devilreraser/hw_crypto_miner_rockerbox/RockerBox_1_SiC780A_Rev02/DOC/Squid Design Specifications2.docx

# Squid Design Specifications

Revision 1.1

Assaf Gilboa and Yisrael Shulman

# 1. Glossary

Serial Loop – The serial loop that connects 8 Hammers in serial protocol and the Squid. The serial loop has serial_in, serial_out, serial_rstn, serial_clk_0 and serial_clk_1

Serial Chain – The serial chain is the serial structure which is built by concatenation of all active serial loop and at its maximum is 24 Serial Loop. The serial chain starts at dispatch point for serial packet and end at Squid as final stop

SPI – Serial Peripheral Interface standard the-facto by Motorola for synchronous serial data link

# 2. Abstract

The Squid is bridging FPGA designed to connect a single CPU with multiple ASICs.

The Squid target FPGA is Altera Cyclone 4: 15K logic elements, 343 user-IOs part# EP4CE15F23C8N package F484 (next pin compatible Altera is 30K).

Utilization target: release with less than 70%

Figure 1 - Squid system view

# 3. Feature list

- SW interface
  - SPI Slave IF - CPOL = 0 CPHA = 0
  - “Squid” serial protocol
    - Squid header
      - Read/ write
      - Squid address
      - Length in 32b
    - Payload
      - Squid register value 32bit
      - Serial transaction packet/s per length
  - Squid register set access
  - Interrupt mechanism
  - 4 GPIO In/Out – Default as Input
  - Serial SW Queue
    - TX Queue for serial packet send
    - RX Queue for serial packet returning to SW (ex. ASIC reads)
    - Can support conditional queuing
- Service routines to reduce SW polling overhead
  - HW periodic polling on 16 preconfigured serial packets
  - Each service routine can generate Interrupt/ status according to response pre
  - Configurable period between HW polling according to desired time (HW timer)
- Chain management – 24 serial loops
  - ASIC serial protocol compliancy
  - Single chain ( 24 serial loops of 8 ASICs -> 192 ASICs)
  - Active loop configuration
    - Any serial chain can be bypassed to handle faulty chain or for address allocation purposes
    - Chain can be reset independently
  - 10K Job per second maximal rate
  - Timeout to detect failing transactions
- Debug
  - HW debug I/F 10 bit bus
  - I2C Slave IF – TBD where to hook it to?

# 4. IO's and PIN assignment

Pin Name | Direction | Description | FPGA PIN | Standart | Notes
GPIO[0] | Inout | | PIN_J1 | 3.3-V LVCMOS
GPIO[1] | Inout | | PIN_H6 | 3.3-V LVCMOS
GPIO[3] | Inout | | PIN_H2 | 3.3-V LVCMOS
GPIO[2] | Inout | | PIN_H5 | 3.3-V LVCMOS
dbg_bus[0] | Out | | PIN_M1 | 3.3-V LVCMOS
dbg_bus[9] | Out | | PIN_R1 | 3.3-V LVCMOS
dbg_bus[1] | Out | | PIN_V1 | 3.3-V LVCMOS
dbg_bus[2] | Out | | PIN_N2 | 3.3-V LVCMOS
dbg_bus[3] | Out | | PIN_V2 | 3.3-V LVCMOS
dbg_bus[4] | Out | | PIN_P2 | 3.3-V LVCMOS
dbg_bus[5] | Out | | PIN_U1 | 3.3-V LVCMOS
dbg_bus[6] | Out | | PIN_P1 | 3.3-V LVCMOS
dbg_bus[7] | Out | | PIN_U2 | 3.3-V LVCMOS
dbg_bus[8] | Out | | PIN_R2 | 3.3-V LVCMOS
i2c_scl | Inout | | PIN_G5 | 3.3-V LVCMOS
i2c_sda | Inout | | PIN_G4 | 3.3-V LVCMOS
int_squid | Out | | PIN_B1 | 3.3-V LVCMOS
IN_REFCLK | In | | PIN_G1 | 3.3-V LVCMOS
ser_clk0[0] | Out | | PIN_AA21 | 1.8 V
ser_clk0[9] | Out | | PIN_AA7 | 1.8 V
ser_clk0[10] | Out | | PIN_AB5 | 1.8 V
ser_clk0[11] | Out | | PIN_V11 | 1.8 V
ser_clk0[12] | Out | | PIN_W10 | 1.8 V
ser_clk0[13] | Out | | PIN_Y3 | 1.8 V
ser_clk0[14] | Out | | PIN_AB19 | 1.8 V
ser_clk0[15] | Out | | PIN_V12 | 1.8 V
ser_clk0[16] | Out | | PIN_AA16 | 1.8 V
ser_clk0[17] | Out | | PIN_V14 | 1.8 V
ser_clk0[18] | Out | | PIN_W17 | 1.8 V
ser_clk0[1] | Out | | PIN_N19 | 1.8 V
ser_clk0[19] | Out | | PIN_B19 | 1.8 V
ser_clk0[20] | Out | | PIN_B16 | 1.8 V
ser_clk0[21] | Out | | PIN_D19 | 1.8 V
ser_clk0[22] | Out | | PIN_F12 | 1.8 V
ser_clk0[23] | Out | | PIN_A4 | 1.8 V
ser_clk0[2] | Out | | PIN_R20 | 1.8 V
ser_clk0[3] | Out | | PIN_U21 | 1.8 V
ser_clk0[4] | Out | | PIN_W20 | 1.8 V
ser_clk0[5] | Out | | PIN_C22 | 1.8 V
ser_clk0[6] | Out | | PIN_F19 | 1.8 V
ser_clk0[7] | Out | | PIN_H21 | 1.8 V
ser_clk0[8] | Out | | PIN_AA3 | 1.8 V
ser_clk1[0] | Out | | PIN_M19 | 1.8 V
ser_clk1[9] | Out | | PIN_AA8 | 1.8 V
ser_clk1[10] | Out | | PIN_AB7 | 1.8 V
ser_clk1[11] | Out | | PIN_V5 | 1.8 V
ser_clk1[12] | Out | | PIN_W6 | 1.8 V
ser_clk1[13] | Out | | PIN_Y6 | 1.8 V
ser_clk1[14] | Out | | PIN_AA13 | 1.8 V
ser_clk1[15] | Out | | PIN_W13 | 1.8 V
ser_clk1[16] | Out | | PIN_AB16 | 1.8 V
ser_clk1[17] | Out | | PIN_V15 | 1.8 V
ser_clk1[18] | Out | | PIN_Y17 | 1.8 V
ser_clk1[1] | Out | | PIN_N20 | 1.8 V
ser_clk1[19] | Out | | PIN_A19 | 1.8 V
ser_clk1[20] | Out | | PIN_B20 | 1.8 V
ser_clk1[21] | Out | | PIN_E12 | 1.8 V
ser_clk1[22] | Out | | PIN_F14 | 1.8 V
ser_clk1[23] | Out | | PIN_B5 | 1.8 V
ser_clk1[2] | Out | | PIN_R21 | 1.8 V
ser_clk1[3] | Out | | PIN_U22 | 1.8 V
ser_clk1[4] | Out | | PIN_W21 | 1.8 V
ser_clk1[5] | Out | | PIN_D20 | 1.8 V
ser_clk1[6] | Out | | PIN_F21 | 1.8 V
ser_clk1[7] | Out | | PIN_H22 | 1.8 V
ser_clk1[8] | Out | | PIN_AB3 | 1.8 V
ser_out[0] | In | | PIN_M21 | 1.8 V
ser_out[9] | In | | PIN_AB10 | 1.8 V
ser_out[10] | In | | PIN_AB9 | 1.8 V
ser_out[11] | In | | PIN_V7 | 1.8 V
ser_out[12] | In | | PIN_W8 | 1.8 V
ser_out[13] | In | | PIN_Y8 | 1.8 V
ser_out[14] | In | | PIN_AA14 | 1.8 V
ser_out[15] | In | | PIN_AA15 | 1.8 V
ser_out[16] | In | | PIN_AB17 | 1.8 V
ser_out[17] | In | | PIN_AB18 | 1.8 V
ser_out[18] | In | | PIN_AB20 | 1.8 V
ser_out[1] | In | | PIN_P22 | 1.8 V
ser_out[19] | In | | PIN_A18 | 1.8 V
ser_out[20] | In | | PIN_C19 | 1.8 V
ser_out[21] | In | | PIN_E15 | 1.8 V
ser_out[22] | In | | PIN_F16 | 1.8 V
ser_out[23] | In | | PIN_C3 | 1.8 V
ser_out[2] | In | | PIN_U19 | 1.8 V
ser_out[3] | In | | PIN_V22 | 1.8 V
ser_out[4] | In | | PIN_Y21 | 1.8 V
ser_out[5] | In | | PIN_D22 | 1.8 V
ser_out[6] | In | | PIN_H19 | 1.8 V
ser_out[7] | In | | PIN_J22 | 1.8 V
ser_out[8] | In | | PIN_AA4 | 1.8 V
ser_in[0] | Out | | PIN_M20 | 1.8 V
ser_in[1] | Out | | PIN_P21 | 1.8 V
ser_in[9] | Out | | PIN_AA9 | 1.8 V
ser_in[10] | Out | | PIN_AB8 | 1.8 V
ser_in[11] | Out | | PIN_V6 | 1.8 V
ser_in[12] | Out | | PIN_W7 | 1.8 V
ser_in[13] | Out | | PIN_Y7 | 1.8 V
ser_in[14] | Out | | PIN_AB13 | 1.8 V
ser_in[15] | Out | | PIN_Y13 | 1.8 V
ser_in[16] | Out | | PIN_AA17 | 1.8 V
ser_in[17] | Out | | PIN_W15 | 1.8 V
ser_in[18] | Out | | PIN_AA20 | 1.8 V
ser_in[19] | Out | | PIN_A16 | 1.8 V
ser_in[20] | Out | | PIN_C17 | 1.8 V
ser_in[21] | Out | | PIN_E13 | 1.8 V
ser_in[22] | Out | | PIN_F15 | 1.8 V
ser_in[23] | Out | | PIN_C10 | 1.8 V
ser_in[2] | Out | | PIN_R22 | 1.8 V
ser_in[3] | Out | | PIN_V21 | 1.8 V
ser_in[4] | Out | | PIN_W22 | 1.8 V
ser_in[5] | Out | | PIN_D21 | 1.8 V
ser_in[6] | Out | | PIN_F22 | 1.8 V
ser_in[7] | Out | | PIN_J21 | 1.8 V
ser_in[8] | Out | | PIN_AA10 | 1.8 V
ser_rstn[0] | Out | | PIN_M22 | 1.8 V
ser_rstn[9] | Out | | PIN_AB4 | 1.8 V
ser_rstn[10] | Out | | PIN_V10 | 1.8 V
ser_rstn[11] | Out | | PIN_V8 | 1.8 V
ser_rstn[12] | Out | | PIN_Y10 | 1.8 V
ser_rstn[13] | Out | | PIN_AA19 | 1.8 V
ser_rstn[14] | Out | | PIN_AB14 | 1.8 V
ser_rstn[15] | Out | | PIN_AB15 | 1.8 V
ser_rstn[16] | Out | | PIN_V13 | 1.8 V
ser_rstn[17] | Out | | PIN_AA18 | 1.8 V
ser_rstn[18] | Out | | PIN_U15 | 1.8 V
ser_rstn[1] | Out | | PIN_R19 | 1.8 V
ser_rstn[19] | Out | | PIN_A20 | 1.8 V
ser_rstn[20] | Out | | PIN_D15 | 1.8 V
ser_rstn[21] | Out | | PIN_E16 | 1.8 V
ser_rstn[22] | Out | | PIN_A10 | 1.8 V
ser_rstn[23] | Out | | PIN_D10 | 1.8 V
ser_rstn[2] | Out | | PIN_U20 | 1.8 V
ser_rstn[3] | Out | | PIN_W19 | 1.8 V
ser_rstn[4] | Out | | PIN_Y22 | 1.8 V
ser_rstn[5] | Out | | PIN_F17 | 1.8 V
ser_rstn[6] | Out | | PIN_H20 | 1.8 V
ser_rstn[7] | Out | | PIN_K15 | 1.8 V
ser_rstn[8] | Out | | PIN_AA5 | 1.8 V
spi_clk | In | | PIN_E1 | 3.3-V LVCMOS
spi_cs | In | | PIN_F2 | 3.3-V LVCMOS
spi_mosi | In | | PIN_E3 | 3.3-V LVCMOS
spi_miso | Out | | PIN_F1 | 3.3-V LVCMOS
uart_rxd | In | | PIN_C2 | 3.3-V LVCMOS | Removed
uart_txd | Out | | PIN_C1 | 3.3-V LVCMOS | Removed

# 5. Squid blocks

Figure 2 - Squid block diagram

## a. SPI Slave Specification

### I. SPI protocol

The SPI mode that in use in the Squid is CPOL = 0 CPHA = 0

The SPI works is also supporting continuous mode of operation where the transaction is longer than a single byte.

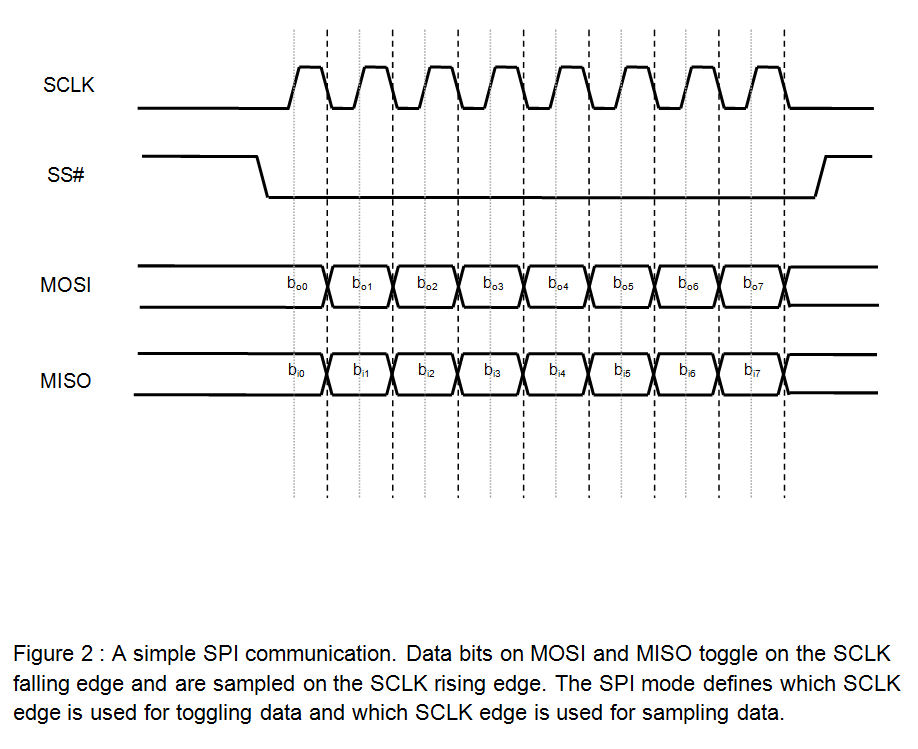
[picture p1: figure]

Figure 3 - SPI protocol

### II. SPI Low level Operation

The SPI I/F is implementing the SPI shift registers. Each sample bit is shifted till 8 shifts are done and entire byte is latched into the next block. Each 8 bits the SPI I/F is latching a ready byte into transmission.

The SPI signals are synchronized and sampled in rate which is 8x the SPI data rate

### III. SPI High level protocol

Squid incoming transaction structure (multiple SPI byte transactions)

Address[7:0] | CMD[1:0] | Length[5:0] | Data [length*32-1:0]
Squid address | 1 – Write 0 – Read | Payload Length in Words (32b) | Payload

Squid outgoing transaction structure (multiple SPI byte transactions)

Garbage[7:0] | Address[7:0] | Data [length*32-1:0]
Don’t care | Incoming Squid address field | Payload: Read – read register’s value Write – incoming reflected write payload

Figure 4 - Squid transaction

The Squid supports read and write transactions. The CPU is issuing a master “incoming Squid transaction” and in parallel the Squid is responding with outgoing transaction (see Figure #4).

When master is issuing WRITE, the Squid is reflecting at the response the written payload.

When master is issuing READ, the Squid is asserting the desired value in the “Payload” field while master “Payload” field is ignored (serves only as place holder)

The first outgoing byte is “Don’t care” since the Squid is decoding the Address at this stage.

## b. Address decoder

The Squid distinguish several types of addresses.

1) Register file - “Simple” configuration 32 bit wide registers
2) Service routine Memory which contains “Hammer Serial” service routine written by SW by address
3) Serial TX FIFO address which serves to store “Hammer’s serial” packets which destined to the Hammer chain. Each write is pushing the 32bit word into the Serial FIFO of transmit (no read access).
4) Serial RX FIFO address which serves to store “Hammer’s serial” packets which returned from the Hammer chain and are marked to be read by SW. Each SW read will pop a 32bit word from the FIFO to the SPI (no write access).
5) Service RX FIFO address which serves to store “Hammer’s serial” packets which returned from the Hammer chain, are marked to be read by SW and originated from the service routine. Each SW read will pop a 32bit word from the FIFO to the SPI (no write access).

Address range | Destination
0x00 – 0x3F | Register file
0x40 – 0x7F | Service routine Memory
0x80 | Serial TX FIFO
0x81 | Serial RX FIFO
0x82 | Service RX FIFO

Table 1 - Address decoding

## c. Serial Queue

The serial Queue is allowing the SW to write continuously into the “Hammer serial” as long as there is an available space in the FIFO.

The TX and RX FIFOs will hold enough space to contain at least 2 full Jobs – 64x32bits words.

The Serial Queue will hold a SW readable status of the both TX Queue and RX Queue and will allow interrupts over full/empty state of the FIFO.

While the TX queue is filled by the SW, the returning RX Queue is filled by the HW. Each “Hammer Serial” transaction sent is returning to the Squid and the Squid parse the “Hammer serial” packet and acts according to the “general” bits at the tail of the packet.

The general bits provide the additional info from which the Squid is routing the “Hammer serial” returning packet to the right Queue or discard it all together

### I. Serial packet general bits usage

- Completion bit by SW (C) – 1 - Store the response if asserted (according to Condition if set). 0 – Discard the returning packet
- Conditional bit by SW (CC) – 1 - Test the “Hammer serial” value to be non-zero. If the value field 16lsb is non-zero and Completion bit asserted – store the packet. 0 – Don’t test the value, act by Completion bit only.
- RX Q destination (Q) – Set by HW (SW shouldn’t use this bit) to designate whether the packet arrived from service or serial Q and to store it at the right RX Q
- HW test (CNT) – bits set by HW to detect “Hammer serial” failures

C bit | CC bit | Action
0 | 0 | No response for the serial packet
0 | 1 | No response for the serial packet
1 | 0 | Store serial packet in Q
1 | 1 | Store serial packet in Q if “Value[15:0]” field is non-zero

Table 2 – General bit Completion and Conditional Completion Action

Figure 5 - Serial Packet general bit

## d. Packet Formatter

Packet Formatter will receive SPI bytes and format these bytes to 32bits transactions according to header. The packet formatter also toggle the bytes of the response to the direction of the SPI.

## e. Loop Management

Each Serial loop can route Serial_in through the Hammer loop or simply short the loop and send Serial_in to serial_out directly. The loop manager is running 10MHz like the Hammer serial. The manager also provide serial clock to the Hammer serial

### I. Bypass

The Squid is enabling bypass per serial loop.

In order to bypass a loop:

1) Verify there is no serial packet in the chain:
  a. Stop the service routine from injecting packets
  b. Serial Q status should be empty
  c. Packets in the chain indication is zero
  d. Write the bypass register with the desired value
2) The loop which bypass is set will pass the serial packet and maintain the loop’s serial_out in zero

### II. Error Detection

The serial chain logic is responsible to detect and report serial errors.

Since a packet is traversing a board and ~200 Hammer chips, there are a lot of failure points along the chain.

Types of errors:

1. Packet corruption – the packet is damaged by mal-operating component
2. Packet is lost – disconnect of serial somewhere

Detection:

1. Packet corruption
  a. Need to be end-to-end since Hammers can change data (parity, CRC will not work properly). The protection is per Chain
  b. Packet based since the packets are cut-thru
  c. Each serial packet entering will be marked with up-counting counter at its CNT general bits (see figure - Serial Packet general bit)
  d. Each serial packet exiting is expecting the “right” marking on the CNT bits
  e. Corrupted packets will have the marking wrong
  f. This marking will protect from serial packet shifts and systematic corruption.
  g. It will not protect from well-formed packets which interior data is bad
2. Packet Loss
  a. Packets which doesn’t return will not be detected by corruption since disappeared
  b. Every packet that goes into a loop MUST come out at the end of loop
  c. A loop is 8 Hammers long and a packet head is exiting a loop before tail has entered
  d. For each “start bit” on serial out trigger a timer, if start bit is not arriving on serial in after TBD configured cycles -> Error
  e. If arrived, reset trigger and wait for next “start bit”

Figure 6 - Loop logic

## f. Service routine - TBD

The Service routine is composed of 16 routines with 64 Words memory which hold Raw SPI protocol data with CMD, Address Etc. The service routine block will pump the data stored in his memory in predefined intervals. The certain service routine is enabled when the service routine are globally enabled as well as per routine enabled. The service routine are taking lower priority than the Serial Queue, and will be entering the serial only if the Serial Queue is idle. The service routine can be globally stopped to allow the SW to “drain” the Hammer serial in cases that reset or bypass are required.

## g. Interrupt service

The Squid has a dedicated line of interrupt towards the ARM. The Interrupt will be asserted when ISR register will hold a non-zero value.

The ISR is a register that holds vector of interrupts bitwise corresponding the STATUS register i.e. STATUS[0] will set ISR[0] if conditions are met.

ISR[i] asserted when:

STATUS[i] & IMR[i] asserted or ISR[i] & ITR[i] & ~ICR[i] & IMR[i]

The first (red) condition is referring to unmasked level events happening

The second (blue) condition is for temporary events that need capture, these events once captured are asserted till cleared.

Please refer to ITR register for sticky/ non-sticky type and ICR register for clear operation.

## h. Register set

Register name | Address | Description
REVISION | 0x0 | Squid RTL revision
STATUS | 0x1 | Squid status and error indications
ISR | 0x2 | Squid interrupt status register
IMR | 0x3 | Squid interrupt mask register
ICR | 0x4 | Squid interrupt clear register
ITR | 0x5 | Squid interrupt type register
PONG | 0xF | Squid fixed value register for “SPI health” read
LOOP_RESET | 0x10 | Squid loop reset vector
LOOP_BYPASS | 0x11 | Squid loop bypass vector
LOOP_TIMEOUT | 0x12 | Squid loop error of disconnection
SCRATCHPAD | 0x1F | Squid scratchpad register for write/read
COMMAND | 0x20 | Squid pulse command
QUEUE_STATUS | 0x21 | Squid Queue status
SERVICE_STATUS | 0x22 | Squid Service Routine status
SR_CONTROL | 0x30-0x3F | Squid Service routines control – 16 routines
SR_MEMORY | 0x40–0x5F | Squid “Serial packets” for service routine 2 per routine
SERIAL_WRITE | 0x80 | Squid serial queue FIFO write address
SERIAL_READ | 0x81 | Squid serial queue FIFO read address
SERVICE_READ | 0x82 | Squid service routine FIFO read address

Table 3 – Squid Register Set

### I. REVISION

The register holds read only

Field | Type | Default | Range | Description
REVISION | RO | | 15:0 | holds the RTL revision of the Squid

### IV. STATUS

Field | Type | Default | Range | Description
// Serial Queue indications
Serial Q TX full | RO | | 0 | The Serial TX FIFO is full
Serial Q TX not empty | RO | | 1 | The Serial TX FIFO is not empty
Serial Q TX empty | RO | | 2 | The Serial TX FIFO is empty
Serial Q RX full | RO | | 3 | The Serial RX FIFO is full
Serial Q RX not empty | RO | | 4 | The Serial RX FIFO is not empty
Serial Q RX empty | RO | | 5 | The Serial RX FIFO is empty
// Service Queue indications
Service Q RX full | RO | | 6 | The Service RX FIFO is full
Service Q RX not empty | RO | | 7 | The Service RX FIFO is not empty
Service Q RX empty | RO | | 8 | The Service RX FIFO is empty
// Queue Errors
FIFO Serial TX Error | RO | | 9 | Serial TX FIFO underrun or overrun
FIFO Serial RX Error | RO | | 10 | Serial RX FIFO underrun or overrun
FIFO Service RX Error | RO | | 11 | Service RX FIFO underrun or overrun
// Loop Indication
Chain Empty | RO | | 12 | The serial loops are empty – no packet is traversing the serial chain
Loop Timeout Error | RO | | 13 | The loop has detected timeout on packet return see LOOP_TIMEOUT
Loop corruption Error | RO | | 14 | The serial loop has returned a malformed serial packet
Illegal access | RO | | 15 | The SW has accessed a non-existing address

### V. ISR

Interrupt Status Register holds the active interrupts of the Squid.

The register is Read Only, Width as STATUS reg.

The register when not zeroed is asserting the interrupt to CPU

Upon Interrupt the SW needs to read and this register.

The ISR bits’ offset is corresponding to the STATUS bit offset (interrupt is available per STATUS bit).

### VI. IMR

Interrupt mask register. Each bit affects the bit order corresponding ISR bit.

The register is of Read-Write type , Width as STATUS reg.

1 - The interrupt will be mask

0 – The interrupt is enabled

Default value is 1 – No interrupts are enabled after reset

### VII. ICR

Interrupt clear register. Each bit affects the bit order corresponding ISR bit.

The register is of Write-Only type (Read will return illegal value), Width as STATUS reg

The Clear act as a clearing pulse to sticky interrupts.

1 – Clear interrupt

0 – Don’t clear

Using the Clear on non-sticky interrupts will have no effect on interrupt

### VIII. ITR

Interrupt type register. Each bit affects the bit order corresponding ISR bit.

The register is of Write-Read, Width as STATUS reg.

The type can be Sticky or non-sticky.

Sticky interrupt is keeping interrupt asserted even if the event has passed ex. Pulse.

The ITR register will be set to the right default value and need not be set by SW (debug only).

By default:

Levels of FIFO (full/empty/non-empty) are non-sticky and shows current state.

Errors are sticky still collected by error pulses and are kept (if not masked) till cleared

### IX. PONG

The register holds read only value.

Field | Type | Default | Range | Description
PONG | RO | 0xDEADBEEF | 31:0 | holds the PONG value for SW polling

The register is for SPI keep alive purposes.

Since the SPI is vital communication channel the SW polls periodically for “health check” of the SPI. The register serves as a fixed SW agreed value that once SW read is mismatched detect SPI hang/ bug.

SPI hang is fatal bug and require Squid reset

### X. LOOP RESET

The loop reset is a vector of reset to the Serial Loop. The reset is directly connected to the Squid SERIAL_RSTN.

Field | Type | Default | Range | Description
SERIAL_RSTN | WR | 0x0 | 23:0 | Each bit is resetting a loop, 0 – reset is active; 1 – reset is inactive.

### XI. LOOP BYPASS

The loop bypass is a register that enable bypassing each loop (see “loop management”).

Note: changes are allowed only when no serial activity or pending packets exist

Field | Type | Default | Range | Description
LOOP BYPASS | WR | 0x0 | 23:0 | Each bit is bypassing a loop, 0 – don’t bypass; 1 – bypass loop insert zeroes to the loop.

### XII. LOOP_TIMEOUT

Field | Type | Default | Range | Description
LOOP TIMEOUT | WR | 0x0 | 23:0 | Bit per loop, 0 – no timeout occur; 1 – timeout occurred.

The LOOP_TIMEOUT holds per loop the event of packet loss in the loop. The loop is detecting “start_bit” and expects to see a “start_bit” returning. If the “start_bit” is not returning throughout the packet (64 cycles), the loop will assert a “loop timeout” which designates a disconnection in the loop.

If “LOOP_TIMEOUT” is non-zero the “STATUS. Loop Timeout Error” will be asserted.

Writing zero to this register will de-assert the “STATUS. Loop Timeout Error”. The register is written by HW when detecting a timeout and by SW clearing a timeout.

### XIII. SCRATCHPAD

A register for read write operations, has no design impact. For bring-up/ SW purposes.

Field | Type | Default | Range | Description
SCRATCHPAD | WR | 0x0 | 31:0 | Has no HW functionality

### XIV. COMMAND

The Command register holds operation modes and reset ability to the Squid

Note: changes are allowed only when no serial activity or pending packets exist

Field | Type | Default | Range | Description
Serial Q TX FIFO reset | WR | 0x0 | 0 | Reset FIFO to empty state, data stored will be lost
Serial Q RX FIFO reset | WR | 0x0 | 1 | Reset FIFO to empty state, data stored will be lost
Service Q RX FIFO reset | WR | 0x0 | 2 | Reset FIFO to empty state, data stored will be lost
Loop logic reset | WR | 0x0 | 3 | Reset serial I/F logic (see detailed)
Service routine enable | WR | 0x0 | 4 | Enable the service routine feature

Loop logic reset – the reset should be done only in extreme cases where the serial I/F is in error state (for debug purposes). The logic under this reset is the insertion of packets to the serial I/F, the bit aggregation of serial packets coming from the serial I/F and the service routine logic. Resetting the loop logic can cause Hammers to receive incomplete packets.

### XV. QUEUE STATUS

Field | Type | Default | Range | Description
Serial TX FIFO Used | RO | | 7:0 | The number of occupied 32bits lines
Serial RX FIFO Used | RO | | 15:8 | The number of occupied 32bits lines
Service RX FIFO Used | RO | | 23:16 | The number of occupied 32bits lines

### XVI. SERVICE_STATUS

Field | Type | Default | Range | Description
SERVICE_STATUS | RO | | 15:0 | Pending Service Routine

The register states whether service routine is pending handling or not. The trivial case is that the SERVICE_STATUS will be zeroes. The register is required to assure when “loop actions” such as bypass and reset are needed, the service routine is not pending completion. When a service routine is pending, need to wait to its completion.

1- Pending Request
2- No Pending request

### XVII. SR_CONTROL

The register is containing the required timer that is used to create the period of the routine and enablement of the routine.

Field | Type | Default | Range | Description
Service Routine Counter | WR | 0x7FFFFFFF | 30:0 | The timer of service routine
Service routine enable | WR | 0x0 | 31 | Enable bit of service routine

The SR_CONTROL registers are 16 registers for service routine 0 to 16.

Each SR_CONTROL and service routine can be set and work independently.

The Service Routine Counter holds the service routine period:

Service Routine Period = Service Routine Counter holds x 100 nS;

Note: Changing timer should be done via enable = 0 only it is no allowed to change timer to a running routine.

The minimal value expected is 500 (50uS).

### XVIII. SR_MEMORY

The SR_MEMORY is the service routine memory space. The Memory is can be read and written in random. No default value exists.

Each service routine takes up 2 consecutive 32bit address ex. Service routine #5 takes addresses (SR_MEMORY_BASE + 0xA) and (SR_MEMORY_BASE + 0xB).

The Service Routine Memory needs to written prior to the SR_CONTROL which enables it.

### XIX. SERIAL_WRITE

Field | Type | Default | Range | Description
SERIAL_WRITE | WO | | 31:0 | Serial Q TX FIFO write address

The register is access to the Serial TX Q FIFO. The write strobe is making a “push” to the FIFO. The register cannot be read. No reset value is relevant.

All accesses to serial I/F are done by writing this address.

Note: Prior to writing the address SW needs to assure the FIFO has sufficient place. Writing a full FIFO will be discarding the overflowing access and potentially make the Squid out of sync.

### XX. SERIAL_READ

Field | Type | Default | Range | Description
SERIAL_READ | RO | | 31:0 | Serial Q RX FIFO read address

The register is access to the Serial RX Q FIFO. The read strobe is making a “pop” to the FIFO. The register cannot be written. No reset value is relevant.

All accesses to returning serial packets are done by reading this address.

Note: Prior to reading the address SW needs to assure the FIFO is not empty. Reading an empty FIFO will be retrieving a non-relevant data and potentially make the Squid out of sync.

### XXI. SERVICE_READ

Field | Type | Default | Range | Description
SERVICE_READ | RO | | 31:0 | Service Q RX FIFO read address

The register is access to the Service RX Q FIFO. The read strobe is making a “pop” to the FIFO. The register cannot be written. No reset value is relevant.

All accesses to service routine returning serial packets are done by reading this address.

Note: Prior to reading the address SW needs to assure the FIFO is not empty. Reading an empty FIFO will be retrieving a non-relevant data and potentially make the Squid out of sync.
