devilreraser/hw_crypto_miner_rockerbox/RockerBox_1_SiC780A_Rev02/DOC/ds_rockerbox_draft_v1.1.pdf

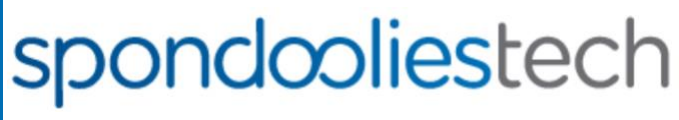
[picture p2: figure]

### www.spondoolies-tech.com

This document contains proprietary and confidential material of Spondoolies-Tech Ltd. Any unauthorized reproduction, use, or disclosure of this material, or any part thereof, is strictly prohibited. This document is solely for the use of Spondoolies-Tech employees and authorized Spondoolies-Tech customers.

The material furnished in this document is believed to be accurate and reliable. However, no responsibility is assumed by Spondoolies-Tech Ltd. for the use of this document or any material included herein.

Spondoolies-Tech Ltd. reserves the right to make changes to this document or any material included herein at any time and without notice.

Spondoolies-Tech, and Hammer are trademarks of
Spondoolies-Tech Ltd.

© Copyright Spondoolies-Tech Ltd. 2014 – Confidential

# RockerBox™ ASIC Data Sheet (Provisional)

# Version 1.1

# Jun 2

## Doc. No. ds_rockerbox_draft.doc

## Part No. Rockerbox

RockerBox™ ASIC

June 14 | i Proprietary and Confidential

This document specifies the electrical, mechanical and thermal parameters of the RockerBox™ Bitcoin mining ASIC.

It is intended for design engineers incorporating the chip into printed circuit boards.

Additionally, its initial chapter can be used as an overview of the RockerBox™ Bitcoin mining ASIC by management and non-technical staff.

RockerBox™ ASIC

June 14 | ii Proprietary and Confidential

### Table of Contents

RockerBox™ ASIC

June 14 | iii Proprietary and Confidential

### 7 About Spondoolies-Tech | 27

7.1 Contact Information | 27

### List of Figures

Figure 1-1: RockerBox™ schematic | 2
Figure 6-2: Package dimensions | 24
Figure 6-3: Recommended footprint – view from top | 25

Figure 6-4: Example of ASIC peripheral layout placement including the companion
Dc/Dc | 26

### List of Tables

Table 1-1: Key system parameters of chip operation in typical corner | 1
Table 4-1: Frequency settings | 11
Table 4-2: Packet structure | 14
Table 4-3: Register set | 15
Table 5-1: Pin assignments | 23

RockerBox™—Overview

June 14 | 1 Proprietary and Confidential

## 1 Overview

The document describes the features and operating flow of the RockerBox chip, a Bitcoin optimized multiple double SHA-256 engines ASIC.

The RockerBox contain 193 double SHA low-power, high-performance engines, which can be chained to any number of other RockerBox ASICs via a proprietary serial interface tailored for this purpose.

## 1.1 Key Features

Double SHA-256 cores

- 193 fully-unrolled engines, each performs a single hash per cycle
- Engine integrity test support—BIST
- Up to 0.2THash/s in typical process corner
- Low power consumption 0.3W/GHps

Built In Self-Test (BIST)

- Engine embedded test mechanism that asserts the integrity of the engine
- Enables validating the adequacy of Operating Condition to engine operation

Power Efficient

- The RockerBox chip can work in core voltages 550—800mV
- Each engine can be shutdown logically or physically by clock shutdown for power save purposes

Serial Interface

- Supports any number of devices on a board
- Seamlessly adding or reducing devices
- Addressing scheme to support ASIC broadcasting transactions
- Low pin count – clock, data in, data out
- Can run up to 50 MHz continuous data rate

Thermal Sensors and thermal shutdown

- Two thermal sensors configures to eight levels. Ranges 90 to 125 °C equally spaced.
- Thermal sensors can invoke engine shutdown upon over-heating, to prevent ASIC meltdown

Configurable PLL

- Supports core frequencies
from 500—1500 MHz.

Table 1-1: Key system parameters of chip operation in typical corner

units
Core voltage | 600 | 700 | mV
Frequency | 900 | 1100 | MHz
Performance | 174 | 212 | GHs
Power/performance | 0.3 | 0.4 | W/GHs
Power | 55 | 90 | W

RockerBox™—Overview

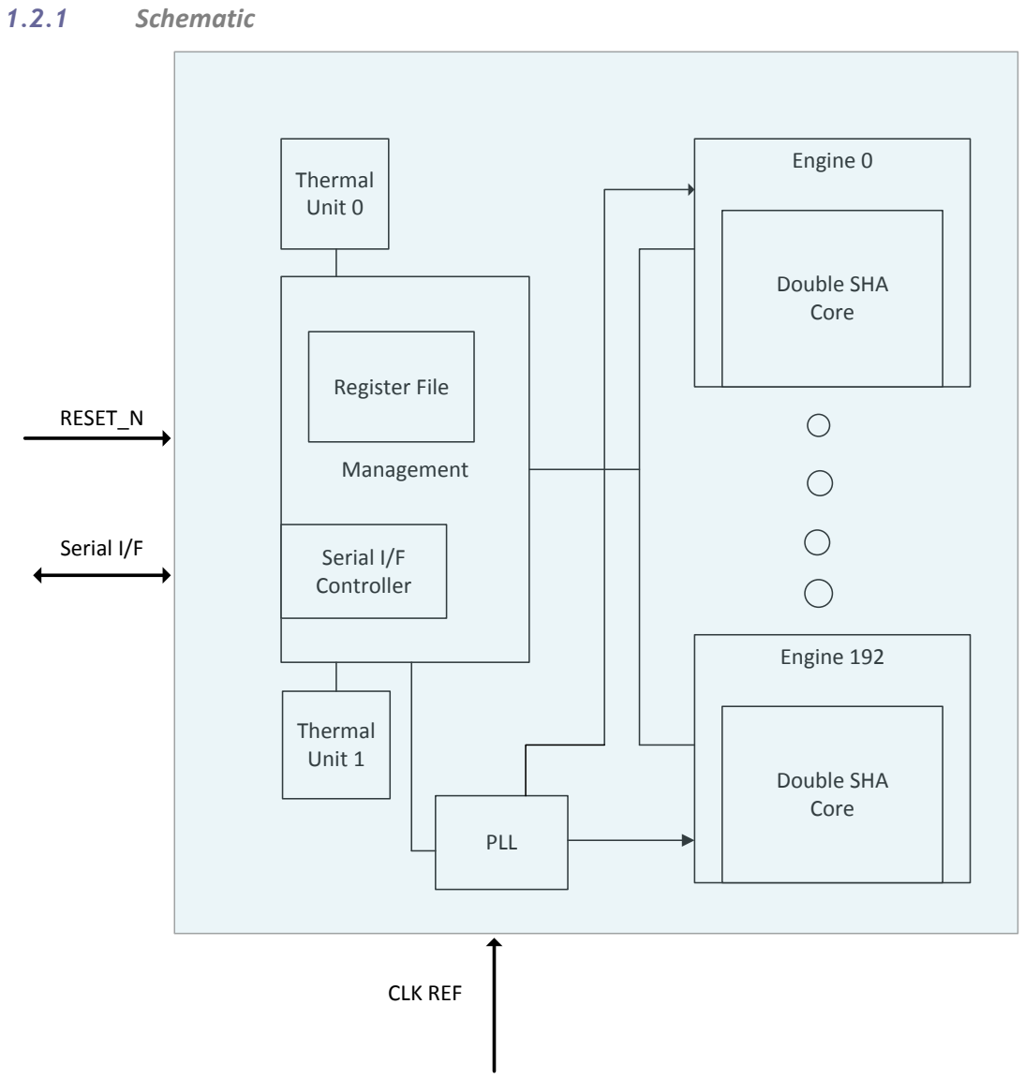
[picture p3: figure]
1.2.1 Schematic; PLL; Thermal Unit 0; Management; Engine 0; Double SHA Core; Engine 192; Thermal Unit 1; Register File; Serial I/F Controller Serial I/F; CLK REF; RESET_N

June 14 | 2 Proprietary and Confidential
1.2 | System Overview

Figure 1-1: RockerBox™ schematic

RockerBox™—Electrical Specifications

June 14 | 3 Proprietary and Confidential

## 2 Electrical Specifications

## 2.1 Normal Operating Conditions

Unless otherwise specified, all DC and AC specifications in this data sheet are valid for the following voltages and temperature ranges.

| Operating Range
Operating Temperature | TA= 0 oC to 70 oC
Parameter | Symbol | Min. | Typical | Max. | Units
Digital Power Supplies | VDDC | 0.60 | 0.70 | 0.80 | VDC
| VDDIO | 1.62 | 1.8 | 1.98 | VDC
Analog Power Supplies for Ambient Temperature | VDDPLLIO | 1.62 | 1.8 | 1.98 | VDC
| VDDPLLC | 0.81 | 0.9 | 0.99 | VDC
| TA | 0 | | 85 | °C
Junction Temperature | TJ | 0 | | 125 | °C
2.2 | Power Requirements
Condition | Parameter | Typical | Max | Units
VDD=0.7V | VDD | 130 | 160 | A
VDD=0.6V | VDD | 90 | 110 | A
VDDIO=1.98V | VDDIO | | 40 | mA
PLLAVDD=1.98 V | PLLAVDD, | | 5 | mA
TSAVDD =1.98V | TSAVDD | | 5 | mA
PLLDVDD=0.99 V | PLLDVDD | | 5 | mA

RockerBox™—Chip Operation

June 14 | 4 Proprietary and Confidential

## 3 Chip Operation

## 3.1 Chip Initialization

The RockerBox™ chip master reset is the RST_N pin. The RST_N is active low asynchronous reset.

### 3.1.1 Reset

1. Assert low the RST_N for 1uS
2. De-assert the RST_N

### 3.1.2 Serial Clock

The serial clock is the management clock of the system; it is always active during operation.

### 3.1.3 Allocating an address

See “Address Allocation” flow.

### 3.1.4 Enabling Global Clocks

The RockerBox has a global hash clock enable and global hash reset enable.

It is recommended to enable the hash clock and reset in the initialization flow.

1. Write ‘1’ to GLOBAL_HASH_RESETN register
2. Write ‘1’ to GLOBAL_CLK_EN register

### 3.1.5 Setting a Frequency

The PLL is turned off by default. You need to initialize the PLL to the desired frequency of operation. See “PLL frequency change”

## 3.2 Address Allocation

Address allocation is the process that assigns an address to the chip.

The chip address register is CHIP_ADDRESS and it holds the 16-bit unique chip address.

Note: the CHIP_ADDRESS register cannot be written when register GOT_ADDRESS is ‘1’. i.e. you cannot change an address to an allocated chip. Need to do address de-allocation first. When getting out of reset the chip is de-allocated
Single chip address allocation:
- Make a serial transaction with following fields: register address CHIP_ADDRESS, chip address 0xFFxx (broadcast), type WRITE, value desired address of 16-bit. The allowable addresses are 256 aligned (0x0, 0x100, 0x200,….,0xFC00) thus single chip chain can contain maximal number of 252 chips.
Single chip address allocation verification:
- Read address allocation status -Make a serial transaction with following fields: register address GOT_ADDRESS, chip address assigned address, type READ, value don’t care

RockerBox™—Chip Operation

June 14 | 5 Proprietary and Confidential

Multiple chips address allocation:

- When several chips are daisy chained, the allocation process is repeated to the number of address unallocated chips chained.
1) De-assert mask the corresponding masking of INTERRUPT_STATUS.GOT_ADDRESS_NOT by broadcast writing ‘0’
2) Broadcast Read “BC_GOT_ADDR_NOT”
3) If value is ‘1’, address unallocated chips exist, broadcast write CHIP_ADDRESS with new address which wasn’t allocated in this chain. Else if value is ‘0’ the process has ended

To de-allocate an address:

- In order to alter a chip’s address, write ‘0’ to the GOT_ADDRESS.
The chip allows removing address to all daisy chained chips by a broadcast write to GOT_ADDRESS

## 3.3 Engine Enable/Disable

The flow details the action to be taken when enabling or disabling engines. You can take enable and disable actions on any number of engines concurrently.

The disable flow also shuts down the engine power-wise, and the shutdown engine will consume a very small fraction of its operating power. This is caused by leakage only (clocks are off and reset is on).

All the actions below can be done to multiple engines and/or in broadcast mode
To enable engine Y:
1. Un reset the engine Y from SERIAL_RESETN_ENGINES_X register:

SERIAL_RESETN_ENGINES_X is a register containing 32 bits vector of active low reset for 32 consecutive engines

Engines 0 to 193 are mapped such that engine Y is mapped to SERIAL_RESETN_ENGINES_{floor(Y/32)}[Y%32]

Write ‘1’ to engine Y mapped bit

2. Un reset the FIFO_RESR_N of an engine by write ‘1’ to CONTROL.FIFO_RESET_N or CONTROL_SET1
3. Enable the engine digital logic by writing ‘1’ to relevant bit in ENABLE_ENGINES_X register (same Y to X bit mapping as detailed above)
To disable engine/engines:
4. Disable the engine digital logic by writing ‘0’ to relevant bit in ENABLE_ENGINES_X register (same Y to X bit mapping as detailed above)
5. Reset the engine by writing ‘0’ to the relevant bit in SERIAL_RESETN_ENGINES_X register (same Y to X bit mapping as detailed above)

RockerBox™—Chip Operation

June 14 | 6 Proprietary and Confidential
3.4 | PLL Frequency Change

To set the PLL frequency:

1. Change frequency when engines are disabled in order to avoid glitches and other undesired phenomena. See “engine enable/ disable” flow
2. Write the desired frequency (according to PLL table) :
a. PLL_CONFIG.M - holds M-1 value where M (Multiplier) is the value of multiplication from Table 4-1
b. PLL_CONFIG.N - holds N-1 value where N (Pre divisor) is the value of pre divisor from Table 4-1
c. PLL_CONFIG.P – holds P-1 value where P (Post divisor) is value of post divisor from Table 4-1
d. PLL_CONFIG.BYPASS – always `0`
e. PLL_CONFIG.FSE – always `1`
3. De-assert PLL_ENABLE by writing ‘0’
4. Assert PLL_ENABLE by writing ‘1’
5. Optionally verify the PLL is ready by reading PLL_STATUS.PLL_READY
6. Optionally verify across all chip daisy chained by broadcast read of BC_PLL_NOT_READY that returning value is zero (all chips are PLL ready)
7. Activate desired engine. See Engine Enable/Disable flow

## 3.5 Thermal Sensor Activation

To activate a thermal sensor:

Both Thermal sensors are off by default. Each can serve for thermal reading only or thermal shutdown only. This section is detailing the sensor reading.

1. Reset the THERMAL_SENSOR_RSTN_0 and/or THERMAL_SENSOR_RSTN_1 by writing ‘0’
2. Set the desired level to compare THERMAL_SENSOR_SET_0.SETTING or/and THERMAL_SENSOR_SET_1.SETTING to a value 0 to 7 correlated to 100,105,110,115,120, 125°C and set THERMAL_SENSOR_SET_0.THERMAL_SHUTDOWN_EN or/and to THERMAL_SENSOR_SET_0.THERMAL_SHUTDOWN_EN ‘0’.
3. Un-Reset the THERMAL_SENSOR_RSTN_0 and/or THERMAL_SENSOR_RSTN_1 by writing ‘1’ to allow reading
4. Reading can be done by a direct read to THERMAL_SENSOR_DATA_0 or/and THERMAL_SENSOR_DATA_1 – a ‘1’ means the temperature is higher than the level set and ‘0’ means the temperature is lower than level set. The accuracy is 5°C and some hysteresis mechanism is implemented in the thermal sensor in order to eliminate noise
5. Another read method is by using broadcast along chain of ASICs and receive the chip address of these ASICs, which are above or below. This can be done by BC_TS_* register family. Please refer to broadcast operation in the Serial Interface chapter.

RockerBox™—Chip Operation

June 14 | 7 Proprietary and Confidential
3.6 | Thermal Shutdown

To configure thermal shutdown:

The chip can protect itself from overheating. The feature is by default disabled and requires activation.

1. Set the SHUTDOWN_ACTION to 0xFFFF. This will minimize the chip power consumption by shutting all engines.
2. Reset the THERMAL_SENSOR_RSTN_0 and/or THERMAL_SENSOR_RSTN_1 by writing ‘0’
3. Set the desired level to compare THERMAL_SENSOR_SET_0.SETTING or/and THERMAL_SENSOR_SET_1.SETTING to a value 0 to 7 correlated to 100,105,110,115,120, 125°C and set THERMAL_SENSOR_SET_0.THERMAL_SHUTDOWN_EN or/and to THERMAL_SENSOR_SET_0.THERMAL_SHUTDOWN_EN ‘1’.
4. Un-Reset the THERMAL_SENSOR_RSTN_0 and/or THERMAL_SENSOR_RSTN_1 by writing ‘1’ to allow reading
5. A periodic broadcast polling on BC_THERMAL_SHUTDOWN register will return ‘1’ ( and address ) if thermal shutdown has occurred.
6. After a shutdown event occurs, the event is stored in the interrupt mechanism as a “sticky” event. We recommend initializing the chip after such event.

3.7 Job

The job flow is the collective registers and actions to have hashing running and monitoring the win. The job is run over the active engines (required at least one engine active) which are preconfigured with the following:

1. Nonce start, which is configured by user to each engine via NONCE_START register
2. The range of nonces to cover, which is configured by user to each engine via NONCE_RANGE register. It is recommended all engines share same range and run same time. This register can be written in broadcast access to all engines in parallel
3. Leading zeroes. This configuration determines the “win” indication criteria as leading zeroes from second hash. The RockerBox supports up to 64 leading zeroes WIN_LEADING_0 register holds the value in each engine.
Per Job
1. Write each relevant (active) engine MIDSTATE0-MIDSTATE7 , MARKEL, DIFFICULTY, TIMESTAMP and optionally JOBID to track the vector (can be written to all engines concurrently).
2. Write the relevant engines with COMMAND.LOAD_FIFO to load the job to FIFO (FIFO overrun is not damaging)
Win Detection
1. Either by reading BC_WIN or INTERRUPT_STATUS.WIN unicast or broadcast
2. Each engine keeps its own WIN, so when reading BC_WIN the response includes winner engine index, the index can be read separately from WINNER_ENGINE_ID
3. Read WINNER_NONCE and WINNER_JOBID for winning parameters

RockerBox™—Chip Operation

June 14 | 8 Proprietary and Confidential
4. Clear the “win” indication at the winning engine by COMMAD.WIN_CLEAR (the command should be addressed to the winner engine)

RockerBox™—Chip Operation

June 14 | 9 Proprietary and Confidential
3.8 | STATUS / INTERRUPT Mechanism

The RockerBox chip supports an interrupt-like mechanism, which is accessed by a read operation.

In order to ease the software managing of numerous devices, each of the status bit is mapped to a unique register for broadcast read.

The mechanism comprises:

1. Interrupt raw register “INTERRUPT_RAW” which holds the indications unmask status
2. Interrupt mask register “INTERUPT_MASK” which masks per bit indications when written ‘1’
3. Interrupt clear register “INTERRUPT_CLEAR” which clears sticky indications when written ‘1’
4. INTERRUPT_STATUS register “INTERRUPT_STATUS” which holds the unmasked indications INTERRUPT_STATUS = INTERRUPT_RAW & ~INTERRUPT_MASK
5. Per INTERRUPT_STATUS broadcast address which spreads each of the INTERRUPT_STATUS bits to unique address for broadcast read purposes

## 3.9 BIST

The BIST flow enables to run all engines in parallel on a well-known job. The participating engines are the enabled one (disable engines will not indicate failure). The BIST should be run as a single Job in the engine/s, i.e. need to wait till BIST ends, read results and only then return to normal operation.

The Job below is a predefined Job with a known expected result, the BIST can be done for each engine and in parallel (in parallel broadcast access can be utilize)

1) Write MID_STATE0 0xBC909A33
2) Write MID_STATE1 0x6358BFF0
3) Write MID_STATE2 0x90CCAC7D
4) Write MID_STATE3 0x1E59CAA8
5) Write MID_STATE4 0xC3C8D8E9
6) Write MID_STATE5 0x4F0103C8
7) Write MID_STATE6 0x96B18736
8) Write MID_STATE7 0x4719F91B
9) Write MERKLE_ROOT 0x4B1E5E4A
10) Write TIMESTAMP 0x29AB5F49
11) Write DIFFICULTY 0xFFFF001D
12) Write WIN_LEADING_0 0x32 (high enough to avoid win over BIST vector)
13) Write BIST_NONCE_START 0x1DAC2A7D
14) Write BIST_NONCE_RANGE 0x200
15) Write BIST_CRC_EXPECTED 0xBDE23FFF
16) Move relevant engine/s to BIST mode – Write CONTROL_SET1 0x1

RockerBox™—Chip Operation

June 14 | 10 Proprietary and Confidential
17) Write the BIST_ALLOWED_FAILURE_NUM register with the tolerance to failed engine
18) Write COMMAND.LOAD_FIFO to the relevant engine/s to commence the BIST start
19) Wait for 2uS or poll on BC_IDLE register to verify BIST is done
20) Read BC_BIST_EXP_FAIL (need to verify the INTERRUPT_MASK is enabling the) should be zero
21) Explicit BIST status per can be read directly from BIST_PASS_X register at each chip (BIST_PASS_0 holds engines 0 to 31 )
22) Clear BIST related wins by COMMAND.WIN_CLEAR to the BIST engines
23) De-assert the BIST mode by write Write CONTROL_SET0 0x1

RockerBox™—Chip Functionality

June 14 | 11 Proprietary and Confidential

## 4 Chip Functionality

## 4.1 PLL Range

The RockerBox chip contains a PLL to clock the hash. We recommend using the system validated 30MHz input reference clock.

The PLL has three parameters to create a frequency: M,N and P.

The output FOUT frequency is computed as follows:

- FVCO = M*FIN/N
- FOUT = FVCO/P

Limitations:

- 10 MHz < FIN < 187.5 MHz
- 1600 MHz < FVCO < 3000 MHz
- Desired engine frequency is FOUT/2 (averaging the engine power consumption)

Table 4-1: Frequency settings

- Recommended setting for FIN=30MHz
Input Frequency (MHz) | N Divider | M Multiplier | P Divider | Engine's Frequency
Range: 10-200 | Range: 1-32 | Range: 16-256 | Range: 1-64 | Range: 500-1000 MHz
30 | 3 | 200 | 2 | 500
30 | 3 | 201 | 2 | 502.5
30 | 3 | 202 | 2 | 505
30 | 3 | 203 | 2 | 507.5
30 | 3 | 204 | 2 | 510
30 | 3 | 205 | 2 | 512.5
30 | 3 | 206 | 2 | 515
30 | 3 | 207 | 2 | 517.5
30 | 3 | 208 | 2 | 520
30 | 3 | 209 | 2 | 522.5
30 | 3 | 210 | 2 | 525
30 | 3 | 211 | 2 | 527.5
30 | 3 | 212 | 2 | 530
30 | 3 | 213 | 2 | 532.5
30 | 3 | 214 | 2 | 535
30 | 3 | 215 | 2 | 537.5
30 | 3 | 216 | 2 | 540
30 | 3 | 217 | 2 | 542.5
30 | 3 | 218 | 2 | 545
30 | 3 | 219 | 2 | 547.5
30 | 3 | 220 | 2 | 550
30 | 3 | 221 | 2 | 552.5
30 | 3 | 222 | 2 | 555
30 | 3 | 223 | 2 | 557.5
30 | 3 | 224 | 2 | 560
30 | 3 | 225 | 2 | 562.5
30 | 3 | 226 | 2 | 565
30 | 3 | 227 | 2 | 567.5
30 | 3 | 228 | 2 | 570
30 | 3 | 229 | 2 | 572.5
30 | 3 | 230 | 2 | 575
30 | 3 | 231 | 2 | 577.5
30 | 3 | 232 | 2 | 580
30 | 3 | 233 | 2 | 582.5
30 | 3 | 234 | 2 | 585
30 | 3 | 235 | 2 | 587.5
30 | 3 | 236 | 2 | 590
30 | 3 | 237 | 2 | 592.5
30 | 3 | 238 | 2 | 595
30 | 3 | 239 | 2 | 597.5
30 | 3 | 240 | 2 | 600
30 | 3 | 241 | 2 | 602.5
30 | 3 | 242 | 2 | 605
30 | 3 | 243 | 2 | 607.5

RockerBox™—Chip Functionality

June 14 | 12 Proprietary and Confidential
30 | 3 | 244 | 2 | 610
30 | 3 | 245 | 2 | 612.5
30 | 3 | 246 | 2 | 615
30 | 3 | 247 | 2 | 617.5
30 | 3 | 248 | 2 | 620
30 | 3 | 249 | 2 | 622.5
30 | 3 | 250 | 2 | 625
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
June 14 | 14 Proprietary and Confidential
4.2 | Serial Interface

The serial interface comprises the following signals:

- SER_CLK – the serial interface clock which can run up to 40 MHz
- SERIN – the data in pin
- SEROUT – the data out pin

### 4.2.1 Packet Structure

Table 4-2: Packet structure

Length | Field | Comment
1 | Start | 1 to start packet
8 | Register Address | See register table
1 | Access Type | 0 write 1 read (can be done only by the master)
8 | Destination Chip Address | 0 – 0xFC : slaves 0xFF : broadcast
8 | Destination Engine Address | 0 – 0xC0 : Engine Address 0xFF : broadcast
1 | Space bit | Reserved for future use
32 | Register Value | Driven by the master for write or by the slave for read Length is dependent on the accessed register
6 | General Purpose Bits | The devices propagate those bits “as is”

### 4.2.2 Transactions Types

- | addressed write: | Master write to specific slave
- | broadcasted write: | Master write to all slaves
- | addressed read: | Master read from specific slave
- | broadcast read: | Master read from all slaves

### 4.2.3 General Notes

- The packet is built of the fields as listed in Table 4-2, in the same bit order.
- Chip has registers per engine (193 instances) and general management registers per chip (1 per chip). Generally engines will contain Job related registers while management will hold interrupt, debug, concentrated indications and PLL related configuration register (see in
| register table)
- Broadcast access options:
| All chips 0xFF

RockerBox™—Chip Functionality

June 14 | 15 Proprietary and Confidential
- All engines within a specific chip: chip address & engine address is 0xFF
- All engines at all chips – chip address is 0xFF, engine address if 0xFF
- Registers addresses are unique. i.e. an address will be either in engines or in chip’s management portion
- Read access is initiated by the master, but the register value field is driven by the slave
- Broadcast read access from engines is not supported

### 4.2.4 Broadcast Read

- Master performs broadcast read to check for the following events:

IDLE state

Win existing

Temperature violation

Temperature exceeding/not a threshold

- A slave whose broadcast accessed register value is ‘0’ will not respond in order to allow other devices with ‘1’ response to assert its value and address

Slave response to broadcast with the following format:
response-value = {chip-addr, register-value[15:0] }

## 4.3 BIST Feature

Each of the engines in the RockerBox has additional logic to determine the engine’s integrity. This logic uses in production testing and during operation when operating conditions might cause the engines to fail.

The BIST is a predefined Job run over a short range of nonces that produces a well-known value that is compared against an accumulated value during the engine run. The BIST is working only when the BIST mode is ON in order save toggle power on regular Jobs.

The BIST logic is covering ~96% of the engine logic and the pass/ fail results is readable by BIST_PASS_* registers and by BC_BIST_FAILED indication.

## 4.4 Register Set

Table 4-3: Register set

Register name | Addr | Type | Default | Offset [b] | Width [b] | Description
CONTROL | 0x2 | WR | 0x0 | | 4
CONTROL.BIST_MODE | | WR | | 0 | 1 | An operation mode to run BIST test. Please refer to “BIST flow”
CONTROL.FIFO_RESET_N | | WR | 0x0 | 2 | 1 | This control resets the engine’s

RockerBox™—Chip Functionality

June 14 | 16 Proprietary and Confidential
CONTROL_SET0 | 0x6 | WO | 0x0 | | 4 | Set corresponding Control Bit to Zero without affecting other control bits
CONTROL_SET1 | 0x7 | WO | 0x0 | | 4 | Set corresponding Control Bit to One without affecting other control bits
COMMAND | 0x3 | WO | 0x0 | | 4
COMMAND.FIFO_LOAD | | WO | | 0 | 1 | Load the FIFO with new Job. Please refer to “Job flow”
COMMAND.WIN_CLEAR | | WO | | 3 | 1 | Clear “WIN” indication this will allow latching another “WIN” and will de-assert the “WIN” indication
MID_STATE0 | 0x50 | WR | | | 32 | Mid-state vector part of Job
MID_STATE1 | 0x51 | WR | | | 32 | Mid-state vector part of Job
MID_STATE2 | 0x52 | WR | | | 32 | Mid-state vector part of Job
MID_STATE3 | 0x53 | WR | | | 32 | Mid-state vector part of Job
MID_STATE4 | 0x54 | WR | | | 32 | Mid-state vector part of Job
MID_STATE5 | 0x55 | WR | | | 32 | Mid-state vector part of Job
MID_STATE6 | 0x56 | WR | | | 32 | Mid-state vector part of Job
MID_STATE7 | 0x57 | WR | | | 32 | Mid-state vector part of Job
MERKLE_ROOT | 0x58 | WR | | | 32 | Markel root part of Job
TIMESTEMP | 0x59 | WR | | 0 | 32 | Timestamp part of Job
DIFFICULTY | 0x5A | WR | | 0 | 32 | Difficulty part of Job
WIN_LEADING_0 | 0x5B | WR | 0x0 | 0 | 6 | Amount of leading zeroes in result
JOBID | 0x5C | WR | 0x0 | 0 | 8 | SW job identifier part of Job
WINNER_JOBID | 0x60 | RO | | 0 | 8 | The register stores the last latched jobid which resulted a WIN for SW identification
WINNER_NONCE | 0x61 | RO | | 0 | 32 | The register hold the last latched winner nonce
WINNER_EXIST | 0x62 | RO | 0x0 | 0 | 1 | “WIN” indication also wired to management register “WIN_x”. x is engine#/32 the bit place is engine#%32
NONCE_START | 0xB0 | WR | | 0 | 32 | Engine’s start point for nonce advancement
NONCE_RANGE | 0xC3 | WR | | 0 | 32 | The nonce range which all engine will cover. The “end” nonce will be nonce_start + nonce_range

RockerBox™—Chip Functionality

June 14 | 17 Proprietary and Confidential
BIST_NONCE_START | 0xD0 | WR | 0x1DAC 2A7C | 0 | 32 | Special nonce start for engines BIST. Please refer to “BIST flow”
BIST_NONCE_RANGE | 0xD1 | WR | 0x00000 200 | 0 | 32 | Special nonce range for engines BIST. Please refer to “BIST flow”
BIST_CRC_EXPECTED | 0xD2 | WR | 0xBDE2 3FFF | 0 | 32 | A pre-configured value that compared against aggregator register. Please refer to “BIST flow”
CHIP_ADDRESS | 0x0 | RW | 0xFD00 | | 16 | Holds the Chip address, Please refer to “Address Allocation flow”
GOT_ADDRESS | 0x1 | RO | 0x0 | | 1 | Denote the address validity. 1 has an address, 0 hasn’t got an address
GLOBAL_CLK_EN | 0x4 | RW | 0x0 | | 1 | A hash clock enable to all engines that needs to be enabled in the “initialization” process
GLOBAL_HASH_RESETN | 0x5 | RW | 0x0 | | 1 | A global hash clock domain active low reset that needs to be enabled in the “initialization” process
MNG_COMMAND | 0x8 | WO | 0x0 | | 4
MNG_COMMAND.TS_RESET_0 | | | 0x0 | 0 | 1 | Reset pulse to Thermal Sensor
MNG_COMMAND.TS_RESET_1 | | | 0x0 | 1 | 1 | Reset pulse to Thermal Sensor
MNG_COMMAND.ZERO_IDLE_COUNTER | | | 0x0 | 3 | 1 | This command will reset the idle counter.
DEBUG_CONTROL | 0x9 | RW | 3'd0 | | 3
DEBUG_CONTROL.DISABLE_TRANSMIT | | | 0x0 | 0 | 1 | Debug option which disables the chip transmitting and keep forwarding the input data
DEBUG_CONTROL.STOP_SERIAL_CHAIN | | | 0x0 | 1 | 1 | Debug option which stops the chain of ASICs by outputting constant zeroes
THERMAL_SENSOR_RSTN_0 | 0xE | RW | 0x0 | | 1 | Reset bit of the Thermal Sensor (active low)
THERMAL_SENSOR _RSTN_1 | 0xF | RW | 0x0 | | 1 | Reset bit of the Thermal Sensor (active low)
PLL_CONFIG | 0x11 | RW | 0x0 | | 21 | PLL frequency setting. Please refer to “PLL change frequency flow”
PLL_CONFIG.PLL_M | | | 0x0 | 0 | 8 | PLL Multiplier
PLL_CONFIG.PLL_N | | | 0x0 | 8 | 5 | PLL Pre divisor

RockerBox™—Chip Functionality

June 14 | 18 Proprietary and Confidential
PLL_CONFIG.PLL_P | | | 0x0 | 13 | 6 | PLL post divisor
PLL_CONFIG.PLL_BYP | | | 0x0 | 19 | 1 | PLL bypass – set to zero at all times
PLL_CONFIG.PLL_FSE | | | 0x0 | 20 | 1 | PLL feedback – set to 1 at all times
PLL_ENABLE | 0x12 | RW | 0x0 | | 1 | PLL action commence register. Please refer to “PLL change frequency flow”
PLL_STATUS | 0x1B | RO | | | 2
PLL_STATUS.PLL_LOCK | | | | 0 | 1 | PLL lock indication
PLL_STATUS.PLL_READY | | | | 1 | 1 | PLL initialization sequence status. 1 – PLL initialization is done
THERMAL_SENSOR_SET_0 | 0x1C | RW | 0x0 | | 4
THERMAL_SENSOR_SET_0.SETTING | | | 0x0 | 0 | 3 | Set level of thermal sensor comparator
THERMAL_SENSOR_SET_0.THERMAL_SH UTDOWN_EN | | | 0x0 | 3 | 1 | Set this thermal sensor to invoke thermal shutdown. Please refer to “thermal shutdown flow”
THERMAL_SENSOR_SET_1 | 0x1D | RW | 0x0 | | 4
THERMAL_SENSOR_SET_1.SETTING | | | 0x0 | 0 | 3 | Set level of thermal sensor comparator
THERMAL_SENSOR_SET_1.THERMAL_SH UTDOWN_EN | | | 0x0 | 3 | 1 | Set this thermal sensor to invoke thermal shutdown. Please refer to “thermal shutdown flow”
THERMAL_SENSOR_DATA_0 | 0x1E | RO | | | 1 | The thermal sensor comparison result. 1 is exceeded and 0 didn’t exceeded the level set
THERMAL_SENSOR_DATA_1 | 0x1F | RO | | | 1 | The thermal sensor comparison result. 1 is exceeded and 0 didn’t exceeded the level set
THERMAL_SENSOR_EN_0 | 0x20 | RW | 0x0 | | 1 | Thermal sensor enablement. 1 is enabled and 0 is disabled
THERMAL_SENSOR_EN_1 | 0x21 | RW | 0x0 | | 1 | Thermal sensor enablement. 1 is enabled and 0 is disabled
SHUTDOWN_ACTION | 0x22 | RW | 0x0 | | 16 | A register which holds the affected engines groups per bit. Refer to “shut down” flow

RockerBox™—Chip Functionality

June 14 | 19 Proprietary and Confidential
INTERRUPT_MASK | 0x30 | RW | 0x0 | | 16 | Per corresponding bit mask in the INTERRUPT_STATUS register. When asserted (active high). The corresponding bit will be zero. Please refer to “interrupt section”
INTERRUPT_CLEAR | 0x31 | WO | | | 16 | Per corresponding bit clear in the INTERRUPT_STATUS register sticky status. When asserted (active high). The corresponding bit will be cleared. Has no effect on non-sticky bits. Please refer to “interrupt section”
INTERRUPT_RAW | 0x32 | RO | | | 16 | Per corresponding bit the INTERRUPT_STATUS register un-masked status for debug. Please refer to “interrupt section”
INTERRUPT_STATUS | 0x33 | RO | | | 16
INTERRUPT_STATUS.GOT_ADDRESS_NOT | | | | 0 | 1 | This status bit indicates when high the chip hasn’t got an address
INTERRUPT_STATUS.WIN | | | | 1 | 1 | This status bit indicates when high the chip has at least 1 WIN asserted at an active engine
INTERRUPT_STATUS.CONDUCTOR_IDLE | | | | 4 | 1 | This status bit indicates when high the chip has at least 1 active engine that is IDLE
INTERRUPT_STATUS.CONDUCTOR_BUSY | | | | 5 | 1 | This status bit indicates when high the chip hasn’t got any active engine that is IDLE
INTERRUPT_STATUS.BIST_FAILURE | | | | 8 | 1 | This status bit indicates when high the chip has BIST failure. Please refer to “BIST” flow
INTERRUPT_STATUS.THERMAL_SHUTDO WN | | | | 9 | 1 | This status bit indicates when high the chip has gone through a thermal shutdown event. Please refer to “Thermal Shutdown” flow
INTERRUPT_STATUS.TS_0_OVER | | | | 11 | 1 | This status bit indicates when high the chip’s Thermal Sensor 0 output is high (set threshold exceeded)
INTERRUPT_STATUS.TS_0_UNDER | | | | 12 | 1 | This status bit indicates when high the chip’s Thermal Sensor 0 output is low (set threshold didn’t exceeded)

RockerBox™—Chip Functionality

June 14 | 20 Proprietary and Confidential
INTERRUPT_STATUS.TS_1_OVER | | | | 13 | 1 | This status bit indicates when high the chip’s Thermal Sensor 1 output is high (set threshold exceeded)
INTERRUPT_STATUS.TS_1_UNDER | | | | 14 | 1 | This status bit indicates when high the chip’s Thermal Sensor 1 output is low (set threshold didn’t exceeded)
INTERRUPT_STATUS.PLL_NOT_READY | | | | 15 | 1 | This status bit indicates when high the chip’s PLL is not ready (engines cannot be activated)
BC_GOT_ADDR_NOT | 0x40 | RO | | | 1 | Single bit read only register which outputs the corresponding INTERRUPT_STATUS bit. These registers allow broadcasting read request to be done over specific indication. i.e. broadcast read of “WIN” will return a unicast address of a winning engine (+ win indication) within the entire system.
BC_WIN | 0x41 | RO | | | 1
BC_CONDUCTOR_IDLE | 0x44 | RO | | | 1
BC_CONDUCTOR_BUSY | 0x45 | RO | | | 1
BC_BIST_EXP_FAIL | 0x48 | RO | | | 1
BC_THERMAL_SHUTDOWN | 0x49 | RO | | | 1
BC_TS_0_OVER | 0x4B | RO | | | 1
BC_TS_0_UNDER | 0x4C | RO | | | 1
BC_TS_1_OVER | 0x4D | RO | | | 1
BC_TS_1_UNDER | 0x4E | RO | | | 1
BC_PLL_NOT_READY | 0x4F | RO | | | 1
VERSION | 0x70 | RO | 0x46 | | 16 | Read only register
ENGINES_PER_CHIP | 0x71 | RO | 0xC1 | | 8 | Read only register
ENABLE_ENGINES_0 | 0x80 | RW | 0x0 | | 32 | Enable engine bit is logical configuration enablement. Please refer to “engine enable/disable” flow. A single register is packing 32 engines enable bits. Engine 0 is controlled by ENABLE_ENGINES_0[0]. Engine 192 is controlled by ENABLE_ENGINES_6[0].
ENABLE_ENGINES_1 | 0x81 | RW | 0x0 | | 32
ENABLE_ENGINES_2 | 0x82 | RW | 0x0 | | 32
ENABLE_ENGINES_3 | 0x83 | RW | 0x0 | | 32
ENABLE_ENGINES_4 | 0x84 | RW | 0x0 | | 32
ENABLE_ENGINES_5 | 0x85 | RW | 0x0 | | 32
ENABLE_ENGINES_6 | 0x86 | RW | 0x0 | | 32
ENABLE_ENGINES_7 | 0x87 | RW | 0x0 | | 32
SERIAL_RESETN_ENGINES_0 | 0x90 | RW | 0x0 | | 32 | Reset engine bit active low. Please refer to “engine
SERIAL_RESETN_ENGINES_1 | 0x91 | RW | 0x0 | | 32
SERIAL_RESETN_ENGINES_2 | 0x92 | RW | 0x0 | | 32

RockerBox™—Chip Functionality

June 14 | 21 Proprietary and Confidential
SERIAL_RESETN_ENGINES_3 | 0x93 | RW | 0x0 | 32 | enable/disable” flow. A single register is packing 32 engines reset bits.
SERIAL_RESETN_ENGINES_4 | 0x94 | RW | 0x0 | 32 | Reset engine bit active low. Please refer to “engine enable/disable” flow.
SERIAL_RESETN_ENGINES_5 | 0x95 | RW | 0x0 | 32
SERIAL_RESETN_ENGINES_6 | 0x96 | RW | 0x0 | 32
SERIAL_RESETN_ENGINES_7 | 0x97 | RW | 0x0 | 32
WINNER_ENGINE_ID | 0xA0 | RO | | 8 | The register holds the first “Winner” engine index. For debug purposes
BIST_FAILED_INDEX | 0xA1 | RO | | 8 | The register holds the first “BIST-Failed” engine index. For debug purposes
CONDUCTOR_IDLE_INDEX | 0xA2 | RO | | 8 | The register holds the first “IDLE” engine index. For debug purposes
IDLE_COUNTER | 0xA3 | RO | | 32 | Debug register which counts whenever active engines are IDLE from work. Can be used for system debug. The counter doesn’t wrap around and zeroed by MNG_COMMAND.ZERO_ID LE_COUNTER
BIST_ALLOWED_FAILURE_NUM | 0xD3 | RW | 0x0 | 8 | The register holds the allowed number of engine failing BIST. Please refer to “BIST” flow
BIST_PASS_0 | 0xD4 | RO | | 32 | BIST passing indication per enabled engine. Please refer to “BIST” flow. A single register is packing 32 engines. Engine 0 is positioned BIST_PASS_0[0]. Engine 192 is positioned by BIST_PASS_6[0].
BIST_PASS_1 | 0xD5 | RO | | 32
BIST_PASS_2 | 0xD6 | RO | | 32
BIST_PASS_3 | 0xD7 | RO | | 32
BIST_PASS_4 | 0xD8 | RO | | 32
BIST_PASS_5 | 0xD9 | RO | | 32
BIST_PASS_6 | 0xDA | RO | | 32
BIST_PASS_7 | 0xDB | RO | | 32
WIN_0 | 0xE0 | RO | | 32 | WIN indication per enabled engine. Please refer to “JOB” flow. A single register is packing 32 engines. Engine 0 is positioned WIN_0[0]. Engine 192 is positioned by WIN_6[0].
WIN_1 | 0xE1 | RO | | 32
WIN_2 | 0xE2 | RO | | 32
WIN_3 | 0xE3 | RO | | 32
WIN_4 | 0xE4 | RO | | 32
WIN_5 | 0xE5 | RO | | 32
WIN_6 | 0xE6 | RO | | 32
WIN_7 | 0xE7 | RO | | 32

RockerBox™—Pin Assignments

June 14 | 22 Proprietary and Confidential

## 5 Pin Assignments

| 1 | 2 | 3 | 4 | 5 | 6 | 7 | 8 | 9 | 10 | 11 | 12 | 13 | 14 | 15 | 16 | 17 | 18 | 19 | 20 | 21 | 22
A | | VSS | VDD | VSS | VDD | VSS | VDD | VSS | VDD | VSS | VDD | VSS | VDD | VSS | VDD | VSS | VDD | VSS | VDD | VSS | PLL_D
| | | | | | | | | | | | | | | | | | | | | VDD | | A
B | VSS | VDD | VSS | VDD | VSS | VDD | VSS | VDD | VSS | VDD | VSS | VDD | VSS | VDD | VSS | VDD | VSS | VDD | VSS | VDD | VSS | VSS | B
C | VDD | VSS | VDD | VSS | VDD | VSS | VDD | VSS | VDD | VSS | VDD | VSS | VDD | VSS | VDD | VSS | VDD | VSS | VDD | VSS | PLL_A
| | | | | | | | | | | | | | | | | | | | | VDD | REF_CLK
| | | | | | | | | | | | | | | | | | | | | | _IN | C
D | VSS | VDD | VSS | VDD | VSS | VDD | VSS | VDD | VSS | VDD | VSS | VDD | VSS | VDD | VSS | VDD | VSS | VDD | VSS | VDD | VSS | VSS | D
E | VDD | VSS | VDD | VSS | VDD | VSS | VDD | VSS | VDD | VSS | VDD | VSS | VDD | VSS | VDD | VSS | VDD | VSS | VDD | VSS | VDD | REF_CLK
| | | | | | | | | | | | | | | | | | | | | | _OUT | E
F | VSS | VDD | VSS | VDD | VSS | VDD | VSS | VDD | VSS | VDD | VSS | VDD | VSS | VDD | VSS | VDD | VSS | VDD | VSS | VDD | VSS | VSS | F
G | VDD | VSS | VDD | VSS | VDD | VSS | VDD | VSS | VDD | VSS | VDD | VSS | VDD | VSS | VDD | VSS | VDD | VSS | VDD | VSS | VDD | TSAVDD | G
H | VSS | VDD | VSS | VDD | VSS | VDD | VSS | VDD | VSS | VDD | VSS | VDD | VSS | VDD | VSS | VDD | VSS | VDD | VSS | VDD | VSS | VSS | H
J | VDD | VSS | VDD | VSS | VDD | VSS | VDD | VSS | VDD | VSS | VDD | VSS | VDD | VSS | VDD | VSS | VDD | VSS | VDD | VSS | VDD | TS2_VRE
| | | | | | | | | | | | | | | | | | | | | | F | J
K | VSS | VDD | VSS | VDD | VSS | VDD | VSS | VDD | VSS | VDD | VSS | VDD | VSS | VDD | VSS | VDD | VSS | VDD | VSS | VDD | VSS | VSS | K
L | VDD | VSS | VDD | VSS | VDD | VSS | VDD | VSS | VDD | VSS | VDD | VSS | VDD | VSS | VDD | VSS | VDD | VSS | VDD | VSS | VDD | TS1_VRE
| | | | | | | | | | | | | | | | | | | | | | F | L
M | VSS | VDD | VSS | VDD | VSS | VDD | VSS | VDD | VSS | VDD | VSS | VDD | VSS | VDD | VSS | VDD | VSS | VDD | VSS | SENSE_V DD | VSS | VMKMOD
| | | | | | | | | | | | | | | | | | | | | | E | M
N | VDD | VSS | VDD | VSS | VDD | VSS | VDD | VSS | VDD | VSS | VDD | VSS | VDD | VSS | VDD | VSS | VDD | VSS | VDD | SENSE_V
| | | | | | | | | | | | | | | | | | | | SS | VDD | SER_CLK | N
P | VSS | VDD | VSS | VDD | VSS | VDD | VSS | VDD | VSS | VDD | VSS | VDD | VSS | VDD | VSS | VDD | VSS | VDD | VSS | VDD | VSS | VSS | P
R | VDD | VSS | VDD | VSS | VDD | VSS | VDD | VSS | VDD | VSS | VDD | VSS | VDD | VSS | VDD | VSS | VDD | VSS | VDD | VSS | VDD | RST_N | R
T | VSS | VDD | VSS | VDD | VSS | VDD | VSS | VDD | VSS | VDD | VSS | VDD | VSS | VDD | VSS | VDD | VSS | VDD | VSS | VDD | VSS | VSS | T
U | VDD | VSS | VDD | VSS | VDD | VSS | VDD | VSS | VDD | VSS | VDD | VSS | VDD | VSS | VDD | VSS | VDD | VSS | VDD | VSS | VDD | SERIN | U
V | VSS | VDD | VSS | VDD | VSS | VDD | VSS | VDD | VSS | VDD | VSS | VDD | VSS | VDD | VSS | VDD | VSS | VDD | VSS | VDD | VSS | VSS | V
W | VDD | VSS | VDD | VSS | VDD | VSS | VDD | VSS | VDD | VSS | VDD | VSS | VDD | VSS | VDD | VSS | VDD | VSS | VDD | VSS | VDD | SEROUT | W
Y | VSS | VDD | VSS | VDD | VSS | VDD | VSS | VDD | VSS | VDD | VSS | VDD | VSS | VDD | VSS | VDD | VSS | VDD | VSS | VDD | VSS | VSS | Y
AA | VDD | VSS | VDD | VSS | VDD | VSS | VDD | VSS | VDD | VSS | VDD | VSS | VDD | VSS | VDD | VSS | VDD | VSS | FFU1 | FFU3 | FFU5 | VDDIO | AA
AB | | VDD | VSS | VDD | VSS | VDD | VSS | VDD | VSS | VDD | VSS | VDD | VSS | VDD | VSS | VDD | VSS | VDD | FFU2 | FFU4 | FFU6 | | AB
| 1 | 2 | 3 | 4 | 5 | 6 | 7 | 8 | 9 | 10 | 11 | 12 | 13 | 14 | 15 | 16 | 17 | 18 | 19 | 20 | 21 | 22
Chip Pin Name | Description
VDDC | VDD Core
PLL_DVDD | PLL VDD Core 0.9V
PLL_AVDD | PLL VDD I/O 1.8V
REF_CLK_IN | Reference clock Oscillator; Can be used as Reference clock input
REF_CLK_OUT | Reference clock Oscillator, left open if not used
VDDIO | Thermal Sensor and I/O VDD 1.8V
VMKMODE | leave unconnected
SER_CLK | Serial Clock Input, Schmitt trigger
TS_AVDD | Thermal sensor 1.8 V
TS1_VREF | leave unconnected
TS2_VREF | leave unconnected
RST_N | Reset input, active low, internal pull down and Schmitt trigger
SERIN | Serial Data Input, internal pull down and Schmitt trigger
SEROUT | Serial Data Output, 12 mA diving strength

RockerBox™—Pin Assignments

June 14 | 23 Proprietary and Confidential
SENSE_VSS | Sense VSS – connected on the die the VSS plane
SENSE_VDD | Sense VDD – connected on the die to VDD plane
FFU | For further use – not connected on the substrate side
VSS | Ground

Table 5-1: Pin assignments

RockerBox™—Mechanical Specifications

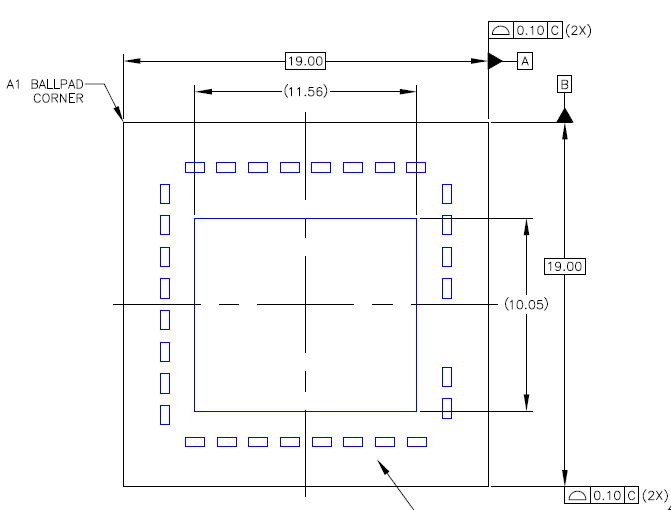
[picture p4: figure]
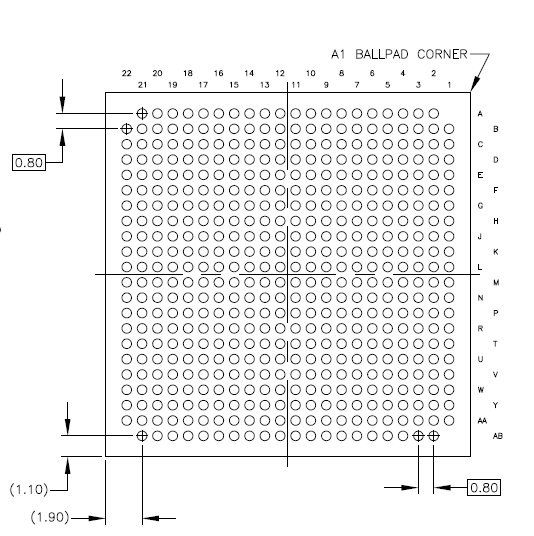
[picture p5: figure]
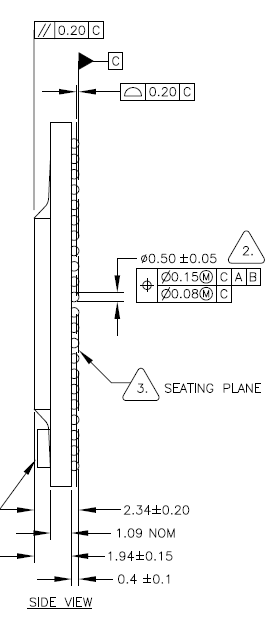
[picture p6: figure]

June 14 | 24 Proprietary and Confidential

## 6 Mechanical Specifications

## 6.1 Package Marking and Outline

FC BGA 19X19mm 0.8mm pitch, 480 balls

Figure 6-1: Package dimensions

RockerBox™—Mechanical Specifications

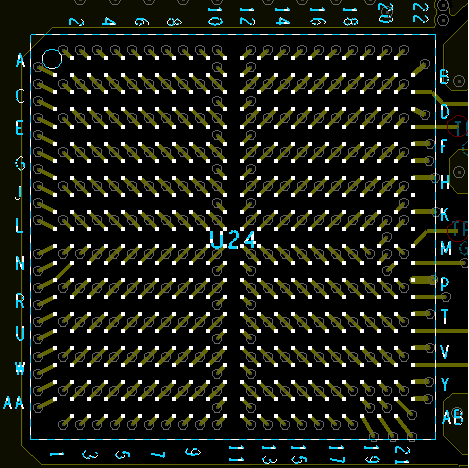
[picture p7: figure]

June 14 | 25 Proprietary and Confidential
6.2 | Recommended footprint – view from top

Figure 6-2: Recommended footprint – view from top

RockerBox™—Mechanical Specifications

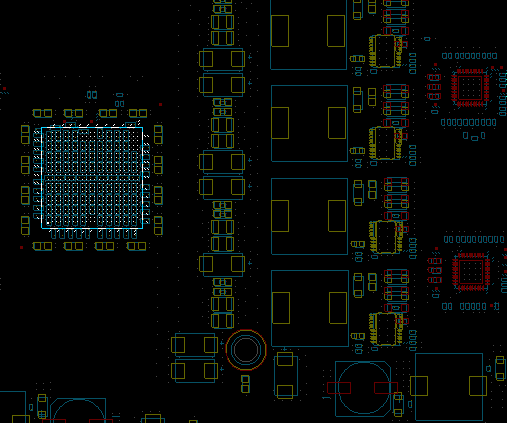
[picture p8: figure]

June 14 | 26 Proprietary and Confidential
6.3 | Example of ASIC Peripheral Layout

Figure 6-3: Example of ASIC peripheral layout placement including the companion Dc/Dc

RockerBox™—About Spondoolies-Tech

June 14 | 27 Proprietary and Confidential

## 7 About Spondoolies-Tech

## 7.1 Contact Information

Spondoolies-Tech Ltd.,
1, Leshem Street
Kiryat Gat,
8258401, Israel
Tel: | +972 8 860 6636
Fax: | +972 8 864 3050
email: | info@spondoolies-tech.com
