devilreraser/hw_crypto_miner_rockerbox/RockerBox_1_SiC780A_Rev02/Project Outputs/BOM/Bill of Materials-RockerBox(Production 1st Proto).xlsx

Bill of Materials
Project: |  |  | RockerBox.PrjPCB
Schematic: |  |  | Block.SchDoc
PCB: |  |  | <Parameter PCBDataSourceFileName not found>
Revision: |  |  | 01
Date: |  |  | 03.12.2014
# | Quantity | Designator |  | Description | Package | Temperature Range | Part Number | Manifacturer's Part number | Datasheet
 | 127 | C1, C14, C16, C18, C19, C36, C37, C38, C39, C40, C62, C63, C65, C66, C67, C74, C75, C76, C77, C78, C79, C80, C81, C90, C128, C130, C131, C138, C139, C141, C142, C144, C145, C147, C148, C149, C150, C151, C152, C153, C154, C155, C156, C157, C158, C159, C160, C161, C162, C163, C164, C165, C166, C168, C169, C170, C172, C173, C175, C176, C177, C178, C179, C180, C181, C182, C183, C184, C185, C186, C187, C188, C190, C191, C193, C194, C196, C197, C199, C200, C202, C203, C205, C206, C217, C218, C219, C220, C221, C222, C223, C224, C225, C226, C228, C229, C230, C231, C234, C235, C236, C263, C264, C265, C266, C268, C269, C271, C272, C274, C275, C331, C332, C333, C334, C652, C654, C655, C657, C658, C660, C661, C663, C664, C666, C667, C669 |  | C X5R 22uF 20% 6.3V 0805 | 0805 | -55 to 85 | CAP000043686 | KEMET C0805C226M9PAC | http://john.epiqdesign.com/projects/CIS_Datasheets/F3102_CE_Kemet.pdf?rev=92&sc=0
 | 48 | C20, C21, C23, C24, C25, C49, C50, C51, C52, C68, C69, C70, C71, C91, C94, C95, C97, C98, C100, C106, C108, C109, C110, C111, C112, C113, C114, C115, C116, C118, C119, C120, C122, C123, C124, C126, C127, C378, C379, C380, C598, C600, C603, C606, C640, C642, C711, C814 |  | C X5R 10uF 10% 16V 0805 | 0805 | -55 to 85 | CAP000043636 | KEMET C0805C106K4PAC | http://john.epiqdesign.com/projects/CIS_Datasheets/F3102_CE_Kemet.pdf?rev=92&sc=0
 | 8 | C4, C5, C6, C7, C8, C9, C17, C232 |  | C X7R 100nF 20% 16V 0402 | 0402 | -55 to 125 | CAP000022751 | KEMET C0402F104M4RAC | http://john.epiqdesign.com/projects/CIS_Datasheets/F3102_CE_Kemet.pdf?rev=92&sc=0
 | 7 | C2, C12, C15, C22, C54, C85, C117 |  | C X5R 10uF 20% 6.3V 0603 | 0603 | -55 to 85 | CAP000043646 | KEMET C0603C106M9PAC | http://john.epiqdesign.com/projects/CIS_Datasheets/F3102_CE_Kemet.pdf?rev=92&sc=0
 | 7 | J9, J13, J14, J15, J22, J23, J24 |  | Mounting Hole PTH_MTG400_700 |  |  | MTH000000030
 | 7 | R1, R2, R6, R9, R15, R17, R23 |  | R SMD 10k 1% 1/10W 0603 | 0603 | -55 to 155 | RES000008663 | YAGEO RC0603FR-0710KL | http://john.epiqdesign.com/projects/CIS_Datasheets/PYu-RC0603_51_RoHS_L_4_YAGEO.pdf?rev=138&sc=0
 | 7 | R7, R8, R18, R20, R21, R22, R29 |  | R SMD 1k 5% 1/10W 0603 | 0603 | -55 to 155 | RES000008858 | YAGEO AC0603JR-071KL | http://john.epiqdesign.com/projects/CIS_Datasheets/RES_AC_YAGEO.pdf?rev=263&sc=0
 | 4 | C26, C58, C89, C121 |  | C X7R 100nF 5% 16V 0603 | 0603 | -55 to 125 | CAP000022706 | KEMET C0603F104J4RAC | http://john.epiqdesign.com/projects/CIS_Datasheets/F3102_CE_Kemet.pdf?rev=92&sc=0
 | 4 | C30, C93, C125, C257 |  | C X7R 220nF 10% 25V 0603 | 0603 | -55 to 125 | CAP000022968 | KEMET C0603F224K3RAC | http://john.epiqdesign.com/projects/CIS_Datasheets/F3102_CE_Kemet.pdf?rev=92&sc=0
 | 4 | L3, L7, L10, L14
 | 4 | R3, R16, R19, R24 |  | R SMD 100R 5% 1/10W 0603 | 0603 | -55 to 155 | RES000006398 | YAGEO RC0603JR-07100R | http://john.epiqdesign.com/projects/CIS_Datasheets/PYu-RC0603_51_RoHS_L_4_YAGEO.pdf?rev=138&sc=0
 | 4 | U13, U17, U20, U24
 | 2 | C10, C11 |  | C C0G 18pF 5% 50V 0603 | 0603 | -55 to 125 | CAP000031922 | KEMET C0603C180J5GAC | http://john.epiqdesign.com/projects/CIS_Datasheets/F3102_CE_Kemet.pdf?rev=92&sc=0
 | 2 | C227, C233 |  | C X7R 470nF 5% 16V 0603 | 0603 | -55 to 125 | CAP000028169 | KEMET C0603C474J4RAC | http://john.epiqdesign.com/projects/CIS_Datasheets/F3102_CE_Kemet.pdf?rev=92&sc=0
 | 2 | FID1, FID2 |  | FIDUCIAL 100x200 | ISHIDDEN=T |  | FID000000001 | ISHIDDEN=T | ISHIDDEN=T
 | 1 | C13 |  | C X5R 220uF 20% 6.3V 1210 | 1210 | -55 to 85 | CAP000047355 | SAMSUNG CL32A227MQVNNNE | http://john.epiqdesign.com/projects/CIS_Datasheets/CAP_CL32A227MQVNNNE.pdf?rev=1401&sc=0
 | 1 | C3 |  | C X7R 1nF 5% 25V 0603 | 0603 | -55 to 125 | CAP000024113 | KEMET C0603C102J3RAC | http://john.epiqdesign.com/projects/CIS_Datasheets/F3102_CE_Kemet.pdf?rev=92&sc=0
 | 1 | C347 |  | C X5R 1uF 20% 6.3V 0603 | 0603 | -55 to 85 | CAP000043344 | KEMET C0603C105M9PAC | http://john.epiqdesign.com/projects/CIS_Datasheets/F3102_CE_Kemet.pdf?rev=92&sc=0
 | 1 | D1 |  | LED RED 0805 | 0805 | -40 to 85 | OPT000000095 | KINGBRIGHT KP-2012EC | http://john.epiqdesign.com/projects/CIS_Datasheets/LED_KP-2012EC_0805_RED.pdf?rev=1358&sc=0
 | 1 | D2 |  | LED GREEN 0805 | 0805 | -40 to 85 | OPT000000096 | KINGBRIGHT KP-2012CGCK | http://john.epiqdesign.com/projects/CIS_Datasheets/LED_KP-2012CGCK_0805_GREEN.pdf?rev=1359&sc=0
 | 1 | D28 |  | D SMCJ12A SMC | SMC | -55 to 150 | DDE000001725 | Diodes SMCJ12A | ISHIDDEN=T
 | 1 | D3 |  | LED YELLOW 0805 | 0805 | -40 to 100 | OPT000000092 | EVERLIGHT 17-21-Y2C-A0L1M2V0B-3T-AM | http://john.epiqdesign.com/projects/CIS_Datasheets/LED_17-21-Y2C-A0L1M2V0B-3T-AM.pdf?rev=1220&sc=0
 | 1 | D4 |  | LED GREEN 0805 | 0805 | -40 to 85 | OPT0000000zz | KINGBRIGHT KP-2012CGCK | http://john.epiqdesign.com/projects/CIS_Datasheets/LED_KP-2012CGCK_0805_GREEN.pdf?rev=1359&sc=0
 | 1 | D6 |  | D SMS05T1G SC-74 | SC-74 | -55 to 150 | DDE000002846 | ON SEMICONDUCTOR SMS05T1G | http://john.epiqdesign.com/projects/CIS_Datasheets/IC_SMS05T1-D.pdf?rev=1323&sc=0
 | 1 | D8 |  | D B140 SMA | SMA | -65 to +150 | DDE000000580 | Diodes B140 | ISHIDDEN=T
 | 1 | J12 |  | CONN PCB 6P M S PTH | PTH | -40 to 105 | CON000000279 | WE 649 006 211 22 | http://john.epiqdesign.com/projects/CIS_Datasheets/CON_6490xx21122.pdf?rev=1438&sc=0
 | 1 | J2 |  | CONN PCB 5P F A USB5 MINI SMD | SMD |  | CON000000048 | CVILUX CU04-SCM15B0-R0-LF | http://john.epiqdesign.com/projects/CIS_Datasheets/USB%20MINI_CVILUX.pdf?rev=249&sc=0
 | 1 | J3 |  | CONN PCB 3P | PTH |  | CON000000272 | HOW DER HD-351-3P | http://john.epiqdesign.com/projects/CIS_Datasheets/CON_hd-351.pdf?rev=1413&sc=0
 | 1 | J4 |  | CONN PCB 4P M S PTH | PTH |  | CON000000298 | CVILUX CH81042V200 | http://john.epiqdesign.com/projects/CIS_Datasheets/CON_CH81XX2H200.pdf?rev=1328&sc=0
 | 1 | J5 |  | CONN PCB 3P M A DC-210-112 | PTH |  | CON000000026 | HONBO DC-210-112 | http://john.epiqdesign.com/projects/CIS_Datasheets/DC210-112_HONBO.pdf?rev=152&sc=0
 | 1 | Q51 |  | TRANS BSS138 SOT-23-3 | SOT-23-3 | -55 to 150 | TRA000001460 | FAIRCHILD BSS138LT1G | http://john.epiqdesign.com/projects/CIS_Datasheets/BSS138LT1-D_Fairchild.pdf?rev=55&sc=0
 | 1 | R10 |  | R SMD 10k 1% 1/10W 0603 | 0603 | -55 to 155 | RES000008663 | YAGEO RC0603FR-0710KL | http://john.epiqdesign.com/projects/CIS_Datasheets/PYu-RC0603_51_RoHS_L_4_YAGEO.pdf?rev=138&sc=0
 | 1 | R11 |  | R SMD 0R 1% 1/10W 0603 | 0603 | -55 to 155 | RES000008926 | YAGEO AC0603FR-070RL | http://john.epiqdesign.com/projects/CIS_Datasheets/RES_AC_YAGEO.pdf?rev=263&sc=0
 | 1 | R12 |  | R SMD 2R 5% 1/4W 1206 | 1206 | -55 to 155 | RES000007051 | YAGEO RC1206JR-072R | http://john.epiqdesign.com/projects/CIS_Datasheets/PYu-RC1206_51_RoHS_L_4_YAGEO.pdf?rev=138&sc=0
 | 1 | R13 |  | R SMD 100R 1% 1/4W 1206 | 1206 | -55 to 155 | RES000006922 | YAGEO RC1206FR-07100R | http://john.epiqdesign.com/projects/CIS_Datasheets/PYu-RC1206_51_RoHS_L_4_YAGEO.pdf?rev=138&sc=0
 | 1 | R14 |  | R SMD 0R 1% 1/4W 1206 | 1206 | -55 to 155 | RES000008756 | YAGEO AC1206FR-070RL | http://john.epiqdesign.com/projects/CIS_Datasheets/RES_AC_YAGEO.pdf?rev=263&sc=0
 | 1 | R27 |  | R SMD 2K 1% 1/10W 0603 | 0603 | -55 to 155 | RES000006259 | YAGEO RC0603FR-072K | http://john.epiqdesign.com/projects/CIS_Datasheets/PYu-RC0603_51_RoHS_L_4_YAGEO.pdf?rev=138&sc=0
 | 1 | R28 |  | R SMD 10K 1% 1/10W 0603 | 0603 | -55 to 155 | RES000006276 | YAGEO RC0603FR-0710K | http://john.epiqdesign.com/projects/CIS_Datasheets/PYu-RC0603_51_RoHS_L_4_YAGEO.pdf?rev=138&sc=0
 | 1 | U1
 | 1 | U10 |  | IC dsPIC33EP256MU806 TQFP-64 | TQFP-64 | -40 to 125 | MCU000000070 | MICROCHIP DSPIC33EP256MU806-E/PT | http://john.epiqdesign.com/projects/CIS_Datasheets/dsPIC33EPxxx-Microchip.pdf?rev=798&sc=0
 | 1 | U29 |  | IC BD00KA5WF-E2 SOIC-8 | SOIC-8 | -40 to 105 | PSU000000128 | ROHM BD00KA5WF-E2 | http://john.epiqdesign.com/projects/CIS_Datasheets/IC_bdxxka5wf-e-209388.pdf?rev=1408&sc=0
 | 1 | U6 |  | IC BD33KA5WF-E2 SOIC-8 | SOIC-8 | -40 to 105 | PSU000000127 | ROHM BD33KA5WF-E2 | http://john.epiqdesign.com/projects/CIS_Datasheets/IC_bdxxka5wf-e-209388.pdf?rev=1408&sc=0
 | 1 | U7 |  | IC L7805CD2T-TR D2PAK | D2PAK | 0 to 125 | PSU000000129 | ST L7805CD2T-TR | http://john.epiqdesign.com/projects/CIS_Datasheets/IC_L7805C.pdf?rev=1409&sc=0
 | 1 | U9 |  | IC BD00KA5WF-E2 SOIC-8 | SOIC-8 | -40 to 105 | PSU000000128 | ROHM BD00KA5WF-E2 | http://john.epiqdesign.com/projects/CIS_Datasheets/IC_bdxxka5wf-e-209388.pdf?rev=1408&sc=0
 | 1 | Y1 |  | IC 4.00MHz HC49/4HSMX SMD | SMD | -10 to 60 | OSC000000012 | IQD 4.00MHz HC49/4HSMX | http://john.epiqdesign.com/projects/CIS_Datasheets/hc49-4hsmx_IQD_oscillators.pdf?rev=713&sc=0
 | 1 | YO5
All information is STRICTLY CONFIDENTIAL. EPIQ Group reserves all rights even in the event of industrial property rights.
We reserve all righsts of disposal such as copying and passing on to third parties.
PRINTED COPIES OF THIS DOCUMENT ARE UNCONTROLLED AND MAY NOT BE CURRENT.
NOTE 1: This file is generated automatically from the Schematic!
NOTE 2: The Ordering code must be respected. Only packaging information may be changed without authorization or notification.
