devilreraser/hw_crypto_miner_rockerbox/RockerBox_1_SiC780A_Rev02/DOC/RockerBox.xlsx

ObjectKind | Pin Designator | Name | Description | X1 | Y1 | Orientation | Electrical Type | Length |  |  |  | Pin Types: | How to use
Pin | A1 | remove |  | -1200mil | 12100mil | 180 Degrees | PASSIVE | 100mil |  |  |  | INPUT | Select from cell A1 down to the last cell in column I ('Length') containing data, and copy this to the clipboard. In Altium Designer, create the correct number of pins (position does not matter) by selecting a pin and cutting it (CTRL+X), then using the paste special»paste array function to paste duplicates of the pin 484 times. Configure the SCHLib List panel to show only pins (by either selecting all pins and filtering by selected parts, or by filtering to show only pins from current part regardless of selection), then use Smart Grid Paste to automatically determine how to paste the data. Be sure to select all rows (or an entire column) in the list panel , or Smart Grid Paste might not operate on them all. See url below for more information on smart grid paste
Pin | A2 | VSS |  | -1200mil | 12000mil | 180 Degrees | PASSIVE | 100mil | Package Type | BGA |  | I/O
Pin | A3 | VDD |  | -1200mil | 11900mil | 180 Degrees | PASSIVE | 100mil | BGA Rows (Letters) | 22 |  | OUTPUT
Pin | A4 | VSS |  | -1200mil | 11800mil | 180 Degrees | PASSIVE | 100mil | BGA Columns (Numbers) | 22 |  | OPEN COLLECTOR
Pin | A5 | VDD |  | -1200mil | 11700mil | 180 Degrees | PASSIVE | 100mil | Total Pin Count: | 484 |  | PASSIVE
Pin | A6 | VSS |  | -1200mil | 11600mil | 180 Degrees | PASSIVE | 100mil |  |  |  | HIZ
Pin | A7 | VDD |  | -1200mil | 11500mil | 180 Degrees | PASSIVE | 100mil | Pin Orientations | 2-sided |  | OPEN EMITTER
Pin | A8 | VSS |  | -1200mil | 11400mil | 180 Degrees | PASSIVE | 100mil | Units: | Imperial (mils) |  | POWER
Pin | A9 | VDD |  | -1200mil | 11300mil | 180 Degrees | PASSIVE | 100mil | Box Width | 2400 | mils
Pin | A10 | VSS |  | -1200mil | 11200mil | 180 Degrees | PASSIVE | 100mil | Vertical Spacing | 100 | mils | Pin Rotation:
Pin | A11 | VDD |  | -1200mil | 11100mil | 180 Degrees | PASSIVE | 100mil | Pin Length | 100 | mils | 0 Degrees
Pin | A12 | VSS |  | -1200mil | 11000mil | 180 Degrees | PASSIVE | 100mil |  |  |  | 90 Degrees
Pin | A13 | VDD |  | -1200mil | 10900mil | 180 Degrees | PASSIVE | 100mil |  |  |  | 180 Degrees
Pin | A14 | VSS |  | -1200mil | 10800mil | 180 Degrees | PASSIVE | 100mil |  |  |  | 270 Degrees
Pin | A15 | VDD |  | -1200mil | 10700mil | 180 Degrees | PASSIVE | 100mil
Pin | A16 | VSS |  | -1200mil | 10600mil | 180 Degrees | PASSIVE | 100mil
Pin | A17 | VDD |  | -1200mil | 10500mil | 180 Degrees | PASSIVE | 100mil
Pin | A18 | VSS |  | -1200mil | 10400mil | 180 Degrees | PASSIVE | 100mil
Pin | A19 | VDD |  | -1200mil | 10300mil | 180 Degrees | PASSIVE | 100mil
Pin | A20 | VSS |  | -1200mil | 10200mil | 180 Degrees | PASSIVE | 100mil
Pin | A21 | PLL_D_VDD |  | -1200mil | 10100mil | 180 Degrees | PASSIVE | 100mil
Pin | A22 | remove |  | -1200mil | 10000mil | 180 Degrees | PASSIVE | 100mil
Pin | B1 | VSS |  | -1200mil | 9900mil | 180 Degrees | PASSIVE | 100mil
Pin | B2 | VDD |  | -1200mil | 9800mil | 180 Degrees | PASSIVE | 100mil
Pin | B3 | VSS |  | -1200mil | 9700mil | 180 Degrees | PASSIVE | 100mil
Pin | B4 | VDD |  | -1200mil | 9600mil | 180 Degrees | PASSIVE | 100mil |  |  |  |  | http://designsecrets.live.altium.com/#Detail/1170
Pin | B5 | VSS |  | -1200mil | 9500mil | 180 Degrees | PASSIVE | 100mil
Pin | B6 | VDD |  | -1200mil | 9400mil | 180 Degrees | PASSIVE | 100mil
Pin | B7 | VSS |  | -1200mil | 9300mil | 180 Degrees | PASSIVE | 100mil |  |  |  |  | Version history:
Pin | B8 | VDD |  | -1200mil | 9200mil | 180 Degrees | PASSIVE | 100mil |  |  |  |  | v1.0 | Initial version from Altium's Jörg Kaleita
Pin | B9 | VSS |  | -1200mil | 9100mil | 180 Degrees | PASSIVE | 100mil |  |  |  |  | v2.0 | Ryan Rutledge - added pin count, pitch, length, and symbol width. Fields are automatically populated except pin names.
Pin | B10 | VDD |  | -1200mil | 9000mil | 180 Degrees | PASSIVE | 100mil |  |  |  |  | v3.0 | Yvon Hache - added Imperial and Metric units and integrate BGA template method from Christopher Leidigh
Pin | B11 | VSS |  | -1200mil | 8900mil | 180 Degrees | PASSIVE | 100mil |  |  |  |  | v3.1 | Ryan Rutledge - corrected imperial units and add DXP default units, and made cells specify their units to reduce errors
Pin | B12 | VDD |  | -1200mil | 8800mil | 180 Degrees | PASSIVE | 100mil |  |  |  |  | v3.2 | Ryan Rutledge - added 1 and 4-sided pin arrangements, made the formulas a little more explanatory
Pin | B13 | VSS |  | -1200mil | 8700mil | 180 Degrees | PASSIVE | 100mil |  |  |  |  | v3.3 | Ryan Rutledge - corrected 4-sided X1 position bug
Pin | B14 | VDD |  | -1200mil | 8600mil | 180 Degrees | PASSIVE | 100mil |  |  |  |  | v3.4 | Ryan Rutledge & Yvon Hache - added indenting to explain formulas better
Pin | B15 | VSS |  | -1200mil | 8500mil | 180 Degrees | PASSIVE | 100mil |  |  |  |  | v3.5 | Ryan Rutledge - added "Description" column, simple use instructions
Pin | B16 | VDD |  | -1200mil | 8400mil | 180 Degrees | PASSIVE | 100mil |  |  |  |  | v3.6 | Ryan Rutledge - refined/corrected pin placement formulas (more monkey power!)
Pin | B17 | VSS |  | -1200mil | 8300mil | 180 Degrees | PASSIVE | 100mil |  |  |  |  | v3.7 | Ryan Rutledge - Corrected right side pins being placed too far left for 2-sided parts
Pin | B18 | VDD |  | -1200mil | 8200mil | 180 Degrees | PASSIVE | 100mil
Pin | B19 | VSS |  | -1200mil | 8100mil | 180 Degrees | PASSIVE | 100mil
Pin | B20 | VDD |  | -1200mil | 8000mil | 180 Degrees | PASSIVE | 100mil
Pin | B21 | VSS |  | -1200mil | 7900mil | 180 Degrees | PASSIVE | 100mil
Pin | B22 | VSS |  | -1200mil | 7800mil | 180 Degrees | PASSIVE | 100mil
Pin | C1 | VDD |  | -1200mil | 7700mil | 180 Degrees | PASSIVE | 100mil
Pin | C2 | VSS |  | -1200mil | 7600mil | 180 Degrees | PASSIVE | 100mil
Pin | C3 | VDD |  | -1200mil | 7500mil | 180 Degrees | PASSIVE | 100mil
Pin | C4 | VSS |  | -1200mil | 7400mil | 180 Degrees | PASSIVE | 100mil
Pin | C5 | VDD |  | -1200mil | 7300mil | 180 Degrees | PASSIVE | 100mil
Pin | C6 | VSS |  | -1200mil | 7200mil | 180 Degrees | PASSIVE | 100mil
Pin | C7 | VDD |  | -1200mil | 7100mil | 180 Degrees | PASSIVE | 100mil
Pin | C8 | VSS |  | -1200mil | 7000mil | 180 Degrees | PASSIVE | 100mil
Pin | C9 | VDD |  | -1200mil | 6900mil | 180 Degrees | PASSIVE | 100mil
Pin | C10 | VSS |  | -1200mil | 6800mil | 180 Degrees | PASSIVE | 100mil
Pin | C11 | VDD |  | -1200mil | 6700mil | 180 Degrees | PASSIVE | 100mil
Pin | C12 | VSS |  | -1200mil | 6600mil | 180 Degrees | PASSIVE | 100mil
Pin | C13 | VDD |  | -1200mil | 6500mil | 180 Degrees | PASSIVE | 100mil
Pin | C14 | VSS |  | -1200mil | 6400mil | 180 Degrees | PASSIVE | 100mil
Pin | C15 | VDD |  | -1200mil | 6300mil | 180 Degrees | PASSIVE | 100mil
Pin | C16 | VSS |  | -1200mil | 6200mil | 180 Degrees | PASSIVE | 100mil
Pin | C17 | VDD |  | -1200mil | 6100mil | 180 Degrees | PASSIVE | 100mil
Pin | C18 | VSS |  | -1200mil | 6000mil | 180 Degrees | PASSIVE | 100mil
Pin | C19 | VDD |  | -1200mil | 5900mil | 180 Degrees | PASSIVE | 100mil
Pin | C20 | VSS |  | -1200mil | 5800mil | 180 Degrees | PASSIVE | 100mil
Pin | C21 | PLL_A_VDD |  | -1200mil | 5700mil | 180 Degrees | PASSIVE | 100mil
Pin | C22 | REF_CLK_IN |  | -1200mil | 5600mil | 180 Degrees | PASSIVE | 100mil
Pin | D1 | VSS |  | -1200mil | 5500mil | 180 Degrees | PASSIVE | 100mil
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
Pin | AA17 | VDD |  | 1200mil | 9400mil | 0 Degrees | PASSIVE | 100mil
Pin | AA18 | VSS |  | 1200mil | 9500mil | 0 Degrees | PASSIVE | 100mil
Pin | AA19 | FFU1 |  | 1200mil | 9600mil | 0 Degrees | PASSIVE | 100mil
Pin | AA20 | FFU3 |  | 1200mil | 9700mil | 0 Degrees | PASSIVE | 100mil
Pin | AA21 | FFU5 |  | 1200mil | 9800mil | 0 Degrees | PASSIVE | 100mil
Pin | AA22 | VDDIO |  | 1200mil | 9900mil | 0 Degrees | PASSIVE | 100mil
Pin | AB1 | remove |  | 1200mil | 10000mil | 0 Degrees | PASSIVE | 100mil
Pin | AB2 | VDD |  | 1200mil | 10100mil | 0 Degrees | PASSIVE | 100mil
Pin | AB3 | VSS |  | 1200mil | 10200mil | 0 Degrees | PASSIVE | 100mil
Pin | AB4 | VDD |  | 1200mil | 10300mil | 0 Degrees | PASSIVE | 100mil
Pin | AB5 | VSS |  | 1200mil | 10400mil | 0 Degrees | PASSIVE | 100mil
Pin | AB6 | VDD |  | 1200mil | 10500mil | 0 Degrees | PASSIVE | 100mil
Pin | AB7 | VSS |  | 1200mil | 10600mil | 0 Degrees | PASSIVE | 100mil
Pin | AB8 | VDD |  | 1200mil | 10700mil | 0 Degrees | PASSIVE | 100mil
Pin | AB9 | VSS |  | 1200mil | 10800mil | 0 Degrees | PASSIVE | 100mil
Pin | AB10 | VDD |  | 1200mil | 10900mil | 0 Degrees | PASSIVE | 100mil
Pin | AB11 | VSS |  | 1200mil | 11000mil | 0 Degrees | PASSIVE | 100mil
Pin | AB12 | VDD |  | 1200mil | 11100mil | 0 Degrees | PASSIVE | 100mil
Pin | AB13 | VSS |  | 1200mil | 11200mil | 0 Degrees | PASSIVE | 100mil
Pin | AB14 | VDD |  | 1200mil | 11300mil | 0 Degrees | PASSIVE | 100mil
Pin | AB15 | VSS |  | 1200mil | 11400mil | 0 Degrees | PASSIVE | 100mil
Pin | AB16 | VDD |  | 1200mil | 11500mil | 0 Degrees | PASSIVE | 100mil
Pin | AB17 | VSS |  | 1200mil | 11600mil | 0 Degrees | PASSIVE | 100mil
Pin | AB18 | VDD |  | 1200mil | 11700mil | 0 Degrees | PASSIVE | 100mil
Pin | AB19 | FFU2 |  | 1200mil | 11800mil | 0 Degrees | PASSIVE | 100mil
Pin | AB20 | FFU4 |  | 1200mil | 11900mil | 0 Degrees | PASSIVE | 100mil
Pin | AB21 | FFU6 |  | 1200mil | 12000mil | 0 Degrees | PASSIVE | 100mil
Pin | AB22 | remove |  | 1200mil | 12100mil | 0 Degrees | PASSIVE | 100mil
