devilreraser/hw_crypto_miner_rockerbox/RockerBox_Rev04/PADS/Gerber/RockerBox_Rev04.xlsx

PartType | RefDes | PartDecal | Pins | Layer | Orient. | X | Y | SMD | Glued | Comment
SMD_0603_CAPC1608X95N | C1 | SMD_0603_CAPC1608X95N | 2 | L1 | 270 | 151.15 | 118.85 | Yes | No
SMD_0603_CAPC1608X95N | C2 | SMD_0603_CAPC1608X95N | 2 | L1 | 180 | 132.6 | 126.3 | Yes | No
SMD_0603_CAPC1608X95N | C3 | SMD_0603_CAPC1608X95N | 2 | L1 | 270 | 149.55 | 118.85 | Yes | No
SMD_0402_CAPC1005X55N | C4 | SMD_0402_CAPC1005X55N | 2 | L1 | 0 | 144.3 | 133.9 | Yes | No
SMD_0402_CAPC1005X55N | C5 | SMD_0402_CAPC1005X55N | 2 | L1 | 270 | 141 | 117.4 | Yes | No
SMD_0402_CAPC1005X55N | C6 | SMD_0402_CAPC1005X55N | 2 | L1 | 90 | 150.25 | 122.35 | Yes | No
SMD_0402_CAPC1005X55N | C7 | SMD_0402_CAPC1005X55N | 2 | L1 | 180 | 132.25 | 125 | Yes | No
SMD_0402_CAPC1005X55N | C8 | SMD_0402_CAPC1005X55N | 2 | L1 | 270 | 150.7 | 126.45 | Yes | No
SMD_0402_CAPC1005X55N | C9 | SMD_0402_CAPC1005X55N | 2 | L1 | 270 | 142.4 | 117.4 | Yes | No
SMD_0603_CAPC1608X95N | C10 | SMD_0603_CAPC1608X95N | 2 | L1 | 0 | 145.15 | 139.05 | Yes | No
SMD_0603_CAPC1608X95N | C11 | SMD_0603_CAPC1608X95N | 2 | L1 | 180 | 142 | 139.05 | Yes | No
SMD_0603_CAPC1608X95N | C12 | SMD_0603_CAPC1608X95N | 2 | L1 | 90 | 137.405 | 183.1 | Yes | No
SMD_1210_CAPC3225X279N | C13 | SMD_1210_CAPC3225X279N | 2 | L1 | 0 | 149.7 | 167.9 | Yes | No
SMD_0805_CAPC2012X145N | C14 | SMD_0805_CAPC2012X145N | 2 | L1 | 180 | 150.3 | 170.8 | Yes | No
SMD_0603_CAPC1608X95N | C15 | SMD_0603_CAPC1608X95N | 2 | L1 | 0 | 150.1 | 178.3 | Yes | No
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
SMD_SOD523_SOD1608X65N | D12 | SMD_SOD523_SOD1608X65N | 2 | L1 | 0 | 127.1 | 226.5 | Yes | No
SMD_SOD523_SOD1608X65N | D13 | SMD_SOD523_SOD1608X65N | 2 | L1 | 0 | 72.7 | 226.5 | Yes | No
SMD_SOD523_SOD1608X65N | D14 | SMD_SOD523_SOD1608X65N | 2 | L1 | 180 | 38.3 | 47 | Yes | No
SMD_SOD523_SOD1608X65N | D15 | SMD_SOD523_SOD1608X65N | 2 | L1 | 180 | 92.7 | 47 | Yes | No
SMD_SOD523_SOD1608X65N | D16 | SMD_SOD523_SOD1608X65N | 2 | L1 | 0 | 113.5 | 226.5 | Yes | No
SMD_SOD523_SOD1608X65N | D17 | SMD_SOD523_SOD1608X65N | 2 | L1 | 0 | 59.1 | 226.5 | Yes | No
SMD_SOD523_SOD1608X65N | D18 | SMD_SOD523_SOD1608X65N | 2 | L1 | 180 | 51.9 | 47 | Yes | No
SMD_SOD523_SOD1608X65N | D19 | SMD_SOD523_SOD1608X65N | 2 | L1 | 180 | 106.3 | 47 | Yes | No
SMD_SOD523_SOD1608X65N | D20 | SMD_SOD523_SOD1608X65N | 2 | L1 | 0 | 99.9 | 226.5 | Yes | No
SMD_SOD523_SOD1608X65N | D21 | SMD_SOD523_SOD1608X65N | 2 | L1 | 0 | 45.5 | 226.5 | Yes | No
SMD_SOD523_SOD1608X65N | D22 | SMD_SOD523_SOD1608X65N | 2 | L1 | 180 | 65.5 | 47 | Yes | No
SMD_SOD523_SOD1608X65N | D23 | SMD_SOD523_SOD1608X65N | 2 | L1 | 180 | 119.9 | 47 | Yes | No
SMD_SOD523_SOD1608X65N | D24 | SMD_SOD523_SOD1608X65N | 2 | L1 | 0 | 86.3 | 226.5 | Yes | No
SMD_SOD523_SOD1608X65N | D25 | SMD_SOD523_SOD1608X65N | 2 | L1 | 0 | 31.9 | 226.5 | Yes | No
SMD_DO214AC_SMC | D26 | SMD_DO214AC_SMC | 2 | L1 | 270 | 78.8 | 30.5 | Yes | No
SMD_DO214AC_SMC | D27 | SMD_DO214AC_SMC | 2 | L1 | 270 | 106 | 30.5 | Yes | No
SMD_DO214AC_SMC | D28 | SMD_DO214AC_SMC | 2 | L1 | 270 | 51.6 | 30.5 | Yes | No
SMD_DO214AC_SMC | D29 | SMD_DO214AC_SMC | 2 | L1 | 90 | 51.6 | 243 | Yes | No
SMD_DO214AC_SMC | D30 | SMD_DO214AC_SMC | 2 | L1 | 90 | 106 | 243 | Yes | No
SMD_DO214AC_SMC | D31 | SMD_DO214AC_SMC | 2 | L1 | 90 | 78.8 | 243 | Yes | No
SMD_DO214AC_SMC | D32 | SMD_DO214AC_SMC | 2 | L1 | 90 | 133.2 | 243 | Yes | No
FID100X200 | FID1 | FID100X200 | 1 | L1 | 0 | 149.105 | 38.4 | Yes | No
FID100X200 | FID2 | FID100X200 | 1 | L1 | 0 | 149.105 | 233.4 | Yes | No
PTH_HDRV05W64P254_1X05 | J1 | PTH_HDRV05W64P254_1X05 | 5 | L1 | 270 | 154.85 | 118.05 | No | No
SMD_CON-CVILUX-CU04-SCM15B0 | J2 | SMD_CON-CVILUX-CU04-SCM15B0 | 11 | L1 | 90 | 151.5 | 151.1 | No | No
PTH_CON_HD-351-3P | J3 | PTH_CON_HD-351-3P | 3 | L1 | 90 | 150.7 | 196.1 | No | No
PTH_CON_WR-MRC4-6P_S | J4 | PTH_CON_WR-MRC4-6P_S | 6 | L1 | 180 | 65.2 | 31.5 | No | No
PTH_CON_WR-MRC4-6P_S | J5 | PTH_CON_WR-MRC4-6P_S | 6 | L1 | 180 | 38 | 31.5 | No | No
PTH_CON_WR-MRC4-6P_S | J6 | PTH_CON_WR-MRC4-6P_S | 6 | L1 | 0 | 92.4 | 242 | No | No
PTH_CON_WR-MRC4-6P_S | J7 | PTH_CON_WR-MRC4-6P_S | 6 | L1 | 0 | 119.6 | 242 | No | No
PTH_CON_WR-MRC4-6P_S | J8 | PTH_CON_WR-MRC4-6P_S | 6 | L1 | 0 | 65.2 | 242 | No | No
PTH_MTG400_700 | J9 | PTH_MTG400_700 | 1 | L1 | 0 | 26 | 136.5 | No | No
PTH_CON_WR-MRC4-6P_S | J10 | PTH_CON_WR-MRC4-6P_S | 6 | L1 | 0 | 38 | 242 | No | No
PTH_CON_WR-MRC4-6P_S | J11 | PTH_CON_WR-MRC4-6P_S | 6 | L1 | 180 | 92.4 | 31.5 | No | No
PTH_CON_WR-MRC4-6P_S | J12 | PTH_CON_WR-MRC4-6P_S | 6 | L1 | 180 | 119.6 | 31.5 | No | No
PTH_MTG400_700 | J13 | PTH_MTG400_700 | 1 | L1 | 0 | 76 | 136.5 | No | No
PTH_MTG400_700 | J14 | PTH_MTG400_700 | 1 | L1 | 0 | 76 | 186.5 | No | No
PTH_MTG400_700 | J15 | PTH_MTG400_700 | 1 | L1 | 0 | 26 | 186.5 | No | No
PTH_MTG400_700 | J16 | PTH_MTG400_700 | 1 | L1 | 0 | 126 | 186.5 | No | No
PTH_MTG400_700 | J17 | PTH_MTG400_700 | 1 | L1 | 0 | 126 | 136.5 | No | No
PTH_MTG400_700 | J18 | PTH_MTG400_700 | 1 | L1 | 0 | 26 | 86.5 | No | No
PTH_MTG400_700 | J19 | PTH_MTG400_700 | 1 | L1 | 0 | 76 | 86.5 | No | No
PTH_MTG400_700 | J20 | PTH_MTG400_700 | 1 | L1 | 0 | 126 | 86.5 | No | No
PTH_MTG400_700 | J21 | PTH_MTG400_700 | 1 | L1 | 0 | 26 | 29.5 | No | No
PTH_MTG400_700 | J22 | PTH_MTG400_700 | 1 | L1 | 0 | 152 | 29.5 | No | No
PTH_MTG400_700 | J23 | PTH_MTG400_700 | 1 | L1 | 0 | 26 | 243.5 | No | No
PTH_MTG400_700 | J24 | PTH_MTG400_700 | 1 | L1 | 0 | 152 | 243.5 | No | No
SMT_INDM135130X800N | L1 | SMT_INDM135130X800N | 2 | L1 | 90 | 28.3 | 68.8 | Yes | No
SMT_INDM135130X800N | L2 | SMT_INDM135130X800N | 2 | L1 | 90 | 82.7 | 68.8 | Yes | No
SMT_INDM135130X800N | L3 | SMT_INDM135130X800N | 2 | L1 | 270 | 123.5 | 204.7 | Yes | No
SMT_INDM135130X800N | L4 | SMT_INDM135130X800N | 2 | L1 | 270 | 69.1 | 204.7 | Yes | No
SMT_INDM135130X800N | L5 | SMT_INDM135130X800N | 2 | L1 | 90 | 41.9 | 68.8 | Yes | No
SMT_INDM135130X800N | L6 | SMT_INDM135130X800N | 2 | L1 | 90 | 96.3 | 68.8 | Yes | No
SMT_INDM135130X800N | L7 | SMT_INDM135130X800N | 2 | L1 | 270 | 109.9 | 204.7 | Yes | No
SMT_INDM135130X800N | L8 | SMT_INDM135130X800N | 2 | L1 | 270 | 55.5 | 204.7 | Yes | No
SMT_INDM135130X800N | L9 | SMT_INDM135130X800N | 2 | L1 | 90 | 55.5 | 68.8 | Yes | No
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
SMD_OSCCF320X400X90-4N | YO4 | SMD_OSCCF320X400X90-4N | 4 | L1 | 270 | 112.9 | 147.9 | Yes | No
SMD_OSCCF250X320X90-4N | YO5 | SMD_OSCCF250X320X90-4N | 4 | L1 | 270 | 62.9 | 147.9 | Yes | No
SMD_OSCCF250X320X90-4N | YO6 | SMD_OSCCF250X320X90-4N | 4 | L1 | 90 | 39.1 | 125.1 | Yes | No
SMD_OSCCF250X320X90-4N | YO7 | SMD_OSCCF250X320X90-4N | 4 | L1 | 90 | 89.1 | 125.1 | Yes | No
SMD_OSCCF250X320X90-4N | YO8 | SMD_OSCCF250X320X90-4N | 4 | L1 | 270 | 112.9 | 147.9 | Yes | No
SMD_OSCCF200X250X90-4N | YO9 | SMD_OSCCF200X250X90-4N | 4 | L1 | 270 | 62.9 | 147.9 | Yes | No
SMD_OSCCF200X250X90-4N | YO10 | SMD_OSCCF200X250X90-4N | 4 | L1 | 90 | 39.1 | 125.1 | Yes | No
SMD_OSCCF200X250X90-4N | YO11 | SMD_OSCCF200X250X90-4N | 4 | L1 | 90 | 89.1 | 125.1 | Yes | No
SMD_OSCCF200X250X90-4N | YO12 | SMD_OSCCF200X250X90-4N | 4 | L1 | 270 | 112.9 | 147.9 | Yes | No
