devilreraser/hw_crypto_miner_rockerbox/(list of files, drawings)

Other design files:
RockerBox_1_SiC780A_Rev01/BitCoin.PcbLib
RockerBox_1_SiC780A_Rev01/BitCoin.SchLib
RockerBox_1_SiC780A_Rev01/Block.SchDoc
RockerBox_1_SiC780A_Rev01/CPU_Logic.SchDoc
RockerBox_1_SiC780A_Rev01/CPU_Power.SchDoc
RockerBox_1_SiC780A_Rev01/MCU.SchDoc
RockerBox_1_SiC780A_Rev01/PADS/RockerBox_1_SiC780A_Rev01.pcb
RockerBox_1_SiC780A_Rev01/RockerBox.PrjPCB
RockerBox_1_SiC780A_Rev01/RockerBox.SchLib
RockerBox_1_SiC780A_Rev01/Schlib1.SchLib
RockerBox_1_SiC780A_Rev01/SMPS.SchDoc
RockerBox_1_SiC780A_Rev02/BitCoin.PcbLib
RockerBox_1_SiC780A_Rev02/BitCoin.SchLib
RockerBox_1_SiC780A_Rev02/Block.SchDoc
RockerBox_1_SiC780A_Rev02/CPU_Logic.SchDoc
RockerBox_1_SiC780A_Rev02/CPU_Power.SchDoc
RockerBox_1_SiC780A_Rev02/MCU.SchDoc
RockerBox_1_SiC780A_Rev02/PADS/RockerBox_1_SiC780A_Rev01.pcb
RockerBox_1_SiC780A_Rev02/PADS/RockerBox_1_SiC780A_Rev02.pcb
RockerBox_1_SiC780A_Rev02/PADS/RockerBox_1_SiC780A_Rev02_Layout.pcb
RockerBox_1_SiC780A_Rev02/RockerBox.PrjPCB
RockerBox_1_SiC780A_Rev02/RockerBox.SchLib
RockerBox_1_SiC780A_Rev02/Schlib1.SchLib
RockerBox_1_SiC780A_Rev02/SMPS.SchDoc
RockerBox_Rev01/BitCoin.PcbLib
RockerBox_Rev01/Block.SchDoc
RockerBox_Rev01/CPU_Logic.SchDoc
RockerBox_Rev01/CPU_Power.SchDoc
RockerBox_Rev01/MCU.SchDoc
RockerBox_Rev01/RockerBox.PrjPCB
RockerBox_Rev01/RockerBox.SchLib
RockerBox_Rev01/Schlib1.SchLib
RockerBox_Rev01/SMPS.SchDoc
RockerBox_Rev04/BitCoin.PcbLib
RockerBox_Rev04/Block.SchDoc
RockerBox_Rev04/CPU_Logic.SchDoc
RockerBox_Rev04/CPU_Power.SchDoc
RockerBox_Rev04/MCU.SchDoc
RockerBox_Rev04/RockerBox.PrjPCB
RockerBox_Rev04/RockerBox.SchLib
RockerBox_Rev04/Schlib1.SchLib
RockerBox_Rev04/SMPS.SchDoc
